jony6/-MechanicalDesign/README.org

#+TITLE: 机械设计项目说明
** 六自由度机械臂
 [[https://github.com/fhln/-MechanicalDesign/tree/master/%E5%85%AD%E8%87%AA%E7%94%B1%E5%BA%A6%E6%9C%BA%E6%A2%B0%E8%87%82][腕关节正交结构机械臂]]，可以通过得到运动学解析解。
** 软体手爪
 自主研发的[[https://github.com/fhln/-MechanicalDesign/tree/master/%E8%BD%AF%E4%BD%93%E6%89%8B%E7%88%AA][欠驱动柔性手爪]]，具有三种抓取模式，可以在非结构化环境中抓取各种尺寸、材质的物体，软体材料固有的柔性保证其抓取过程的安全性灵活性，表面采用微型吸盘阵列改善抓取力和抓取效果，同时附有真空气压、微型触碰开关等传感器，具有一定的自感知和自动抓取能力。
*** Publications&Award
    + [[http://2017.icrita.org/?p=1051][Design and Analysis of a Novel Sucked-type Underactuated Hand with Multiple Grasping Modes]]
    + A New Grasping Mode Based on a Sucked-Type Underactuated Hand [J]. Chinese Journal of Mechanical Engineering, Accepted
    + 2017 RoboCup@Home Best in Manipulation Award (Nagoya, Japan)
*** \cite:
  @inproceedings{lin2017design,
  title={Design and Analysis of a Novel Sucked-Type Underactuated Hand with Multiple Grasping Modes},
  author={Lin, Nan and Wu, Peichen and Tan, Xiao and Zhu, Jinhua and Guo, Zhenjiang and Qi, Xinbo and Chen, Xiaoping},
  booktitle={International Conference on Robot Intelligence Technology and Applications},
  pages={299--312},
  year={2017},
  organization={Springer}
}
** 软体机械臂
   [[https://github.com/fhln/-MechanicalDesign/tree/master/%E8%BD%AF%E4%BD%93%E6%9C%BA%E6%A2%B0%E8%87%82][硅胶变刚度软体机械臂，具有无限自由度]]
** 软体驱动器
   Coming soon..
