jony6/-MechanicalDesign/软体手爪/README.org

#+TITLE: 软体手爪
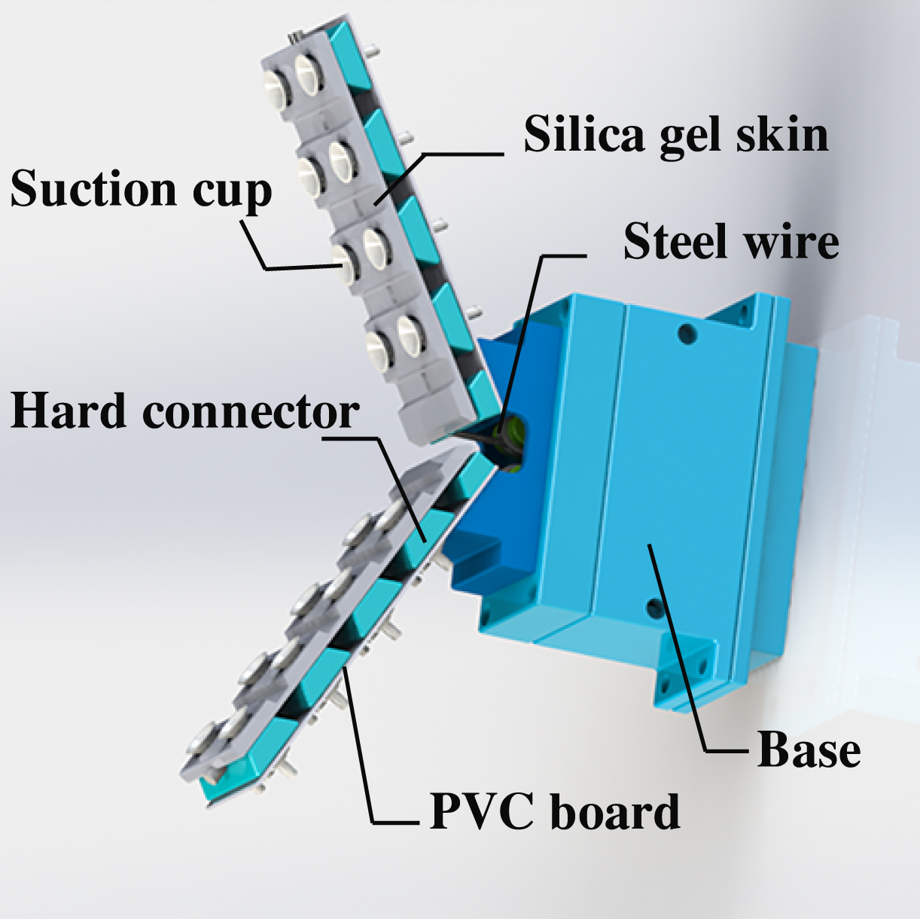
[picture p1: 软体手爪/img/schematic.jpg]

柔性被动自适应手爪，结构如上图所示.可以抓取多种物体. 用于可佳机器人获得RoboCup@Home 2017 [[https://www.ustc.edu.cn/news/mtgz/201708/t20170803_280644.html][Best in Manipulation Award]] (Japan) 和 RiTA conference 2017 [[http://2017.icrita.org/?p=1051][Best Paper Award]] .

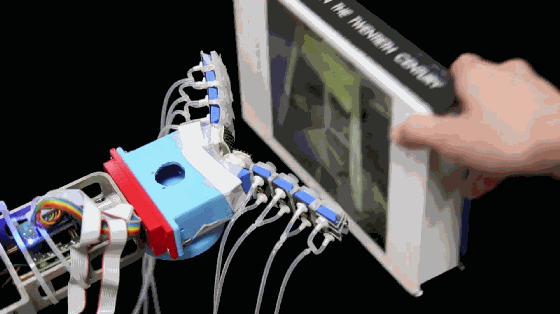
[picture p2: 软体手爪/img/书.gif]

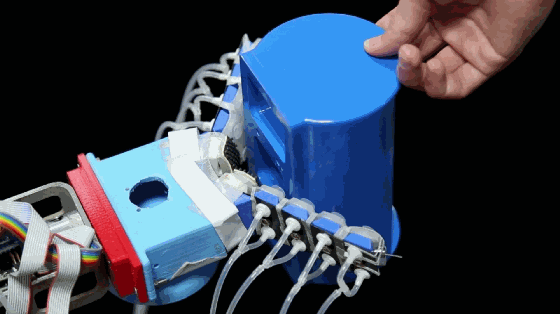
[picture p3: 软体手爪/img/可佳云台壳子.gif]

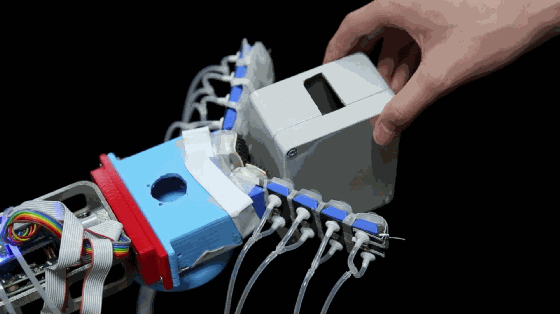
[picture p4: 软体手爪/img/塑料盒.gif]

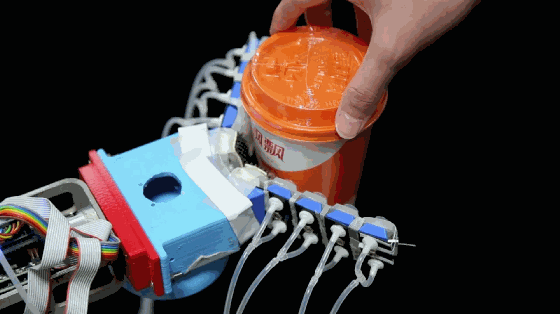
[picture p5: 软体手爪/img/奶茶.gif]

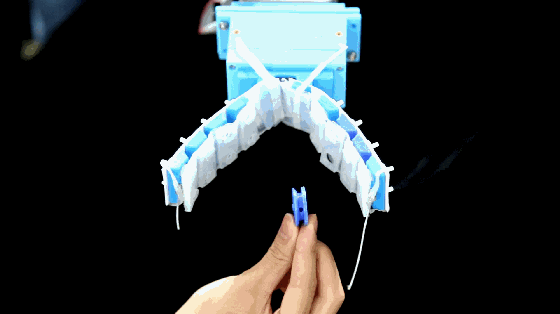
[picture p6: 软体手爪/img/小零件.gif]


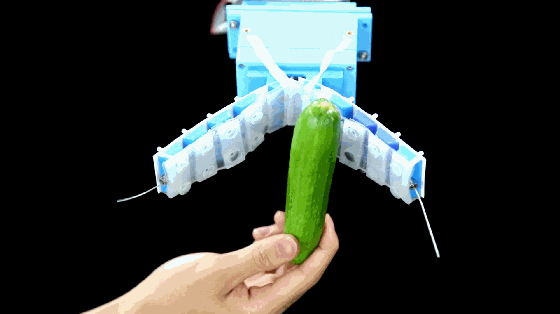
[picture p7: 软体手爪/img/捏黄瓜.gif]

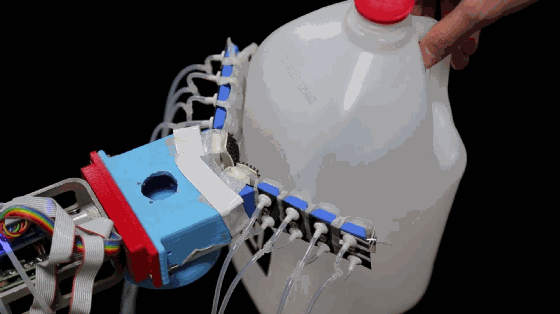
[picture p8: 软体手爪/img/水桶.gif]

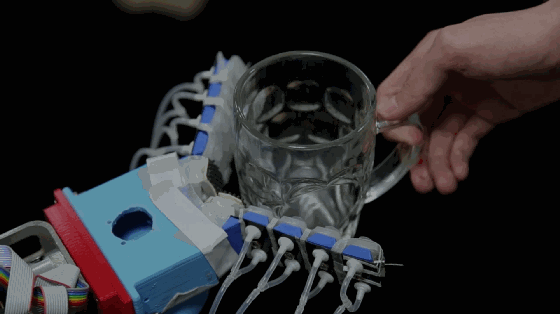
[picture p9: 软体手爪/img/玻璃杯.gif]

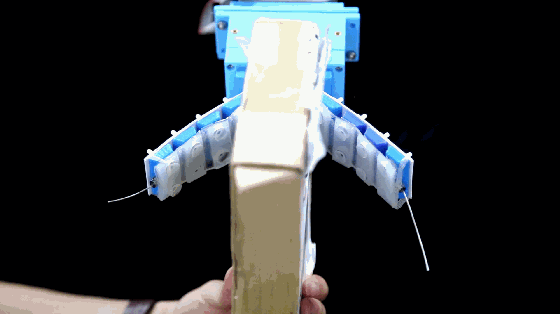
[picture p10: 软体手爪/img/盒子.gif]

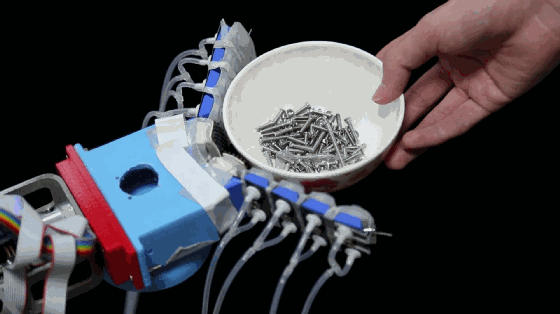
[picture p11: 软体手爪/img/盛物碗.gif]

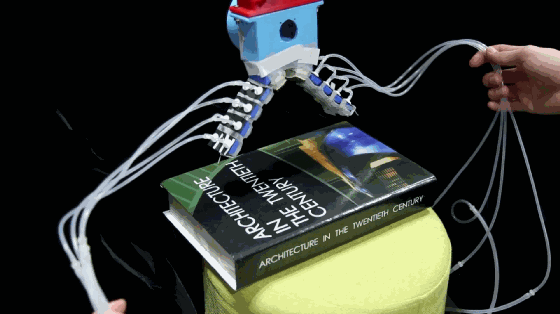
[picture p12: 软体手爪/img/竖直抓书.gif]

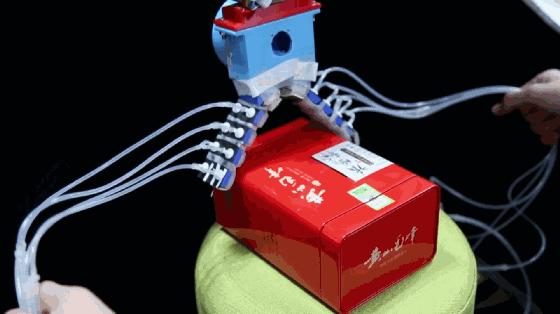
[picture p13: 软体手爪/img/竖直抓茶叶盒.gif]

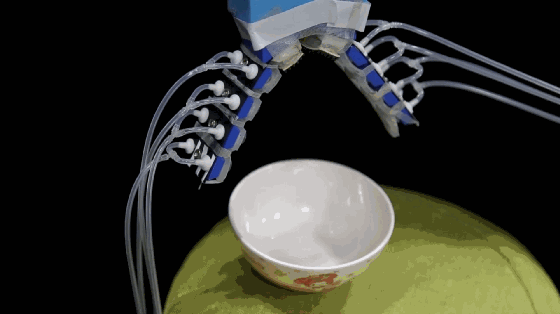
[picture p14: 软体手爪/img/纵向抓碗.gif]

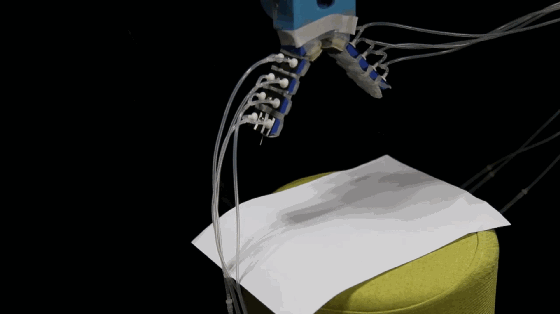
[picture p15: 软体手爪/img/纸.gif]

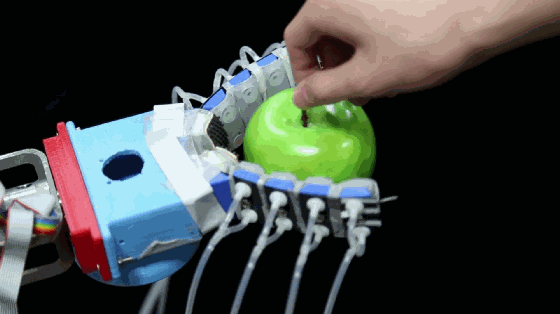
[picture p16: 软体手爪/img/绿苹果.gif]

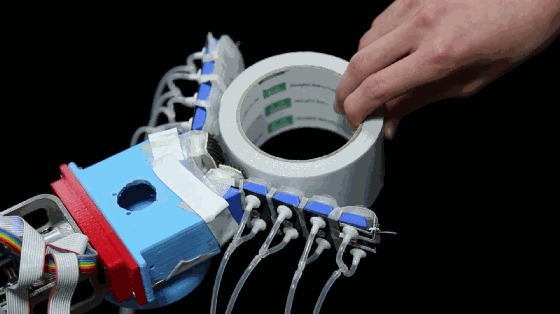
[picture p17: 软体手爪/img/胶带.gif]

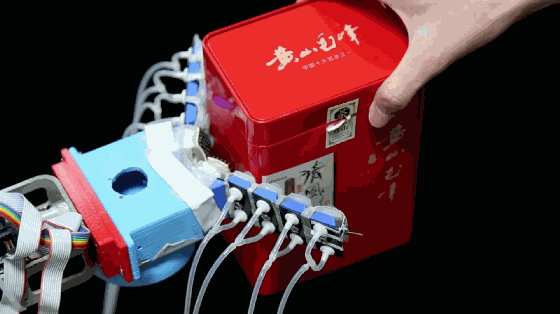
[picture p18: 软体手爪/img/茶叶罐.gif]

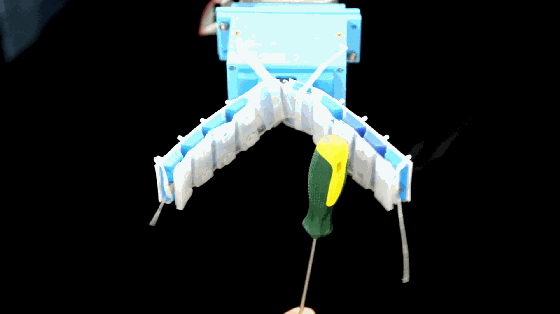
[picture p19: 软体手爪/img/螺丝刀.gif]

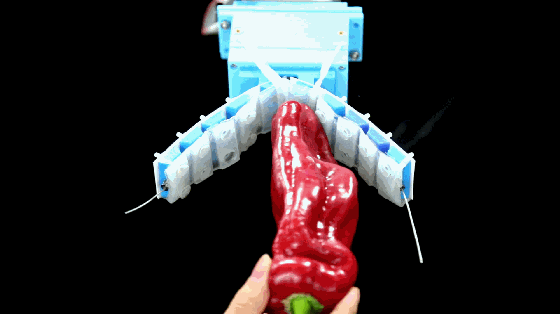
[picture p20: 软体手爪/img/辣椒.gif]

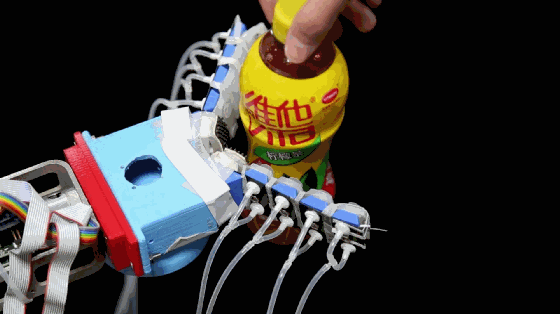
[picture p21: 软体手爪/img/饮料瓶.gif]

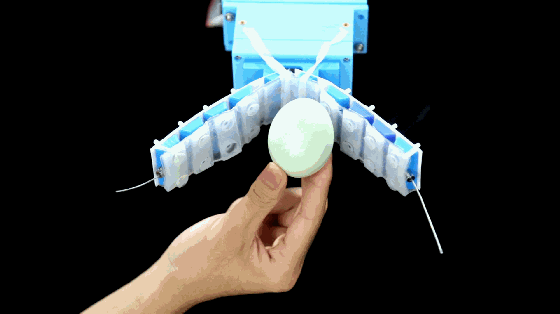
[picture p22: 软体手爪/img/鸭蛋.gif]
