jony6/-MechanicalDesign/六自由度机械臂/建模分析.pdf

中国科学技术大学学士学位论文

### 第三章 机械臂运动学和动力学

### 3.1 运动学简介

机械臂运动学最基本的目的是得到关节空间到末端操作件的位姿的映射关 系。此由变换矩阵 ⁰

nT 唯一确定。关节变量定义为 q=[q1, ...qn]

n。因此，运动学
问题即是研究 q 与 0

nT 之间的关系。
运动学问题可分为两类。一个是正运动学问题，已知关节变量 q 求相应的

0

nT(q)。另一个是逆运动学问题，即已知 ⁰

nT，求出对应的 q。另外还有一些问题，
如求工作空间、奇异点的位置，也可以算是运动学的衍生。

### 3.1.1 刚体位姿的表述

自由刚体在空间中有六个自由度，因此可以通过六个参数来确定刚体在空 间中的位姿。刚体的指向可以通过其与参考坐标系的相对位置来描述。记刚体坐 标系 O1ξηζ（以下简称系 1）中的三个单位向量 n、o、a 在参考坐标系 OXYZ(以 下简称系 0) 中的表达式是

0n =

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
则可以用 3X3 的矩阵来表示刚体相对参考坐标系的指向：

0R1 ≜

nx | ox | ax
ny | oy | ay
nz | oz | az

=

[

0n

0o

0a

]

### 3.1.2 旋转变换

如果标记旋转前的坐标系为系 0，旋转后的坐标系为系 1，称 0R1 为从系 0 到系 1 的旋转矩阵。如有一个矢量 b,b 在系 0 中的表示为 0b，在系 1 中的表示 为 1b，则

1b =
0 R1 ·

0 b

### 3.1.2.1 基本旋转矩阵

绕坐标轴 X、Y、Z 旋转称为基本旋转。对应的旋转矩阵为

Rx =

1 | 0 | 0
0 cos θ − sin θ
0 sin θ cos θ

, Ry =

cos θ | 0 sin θ
0 | 1 | 0
− sin θ 0 cos θ

, Rz =

cos θ − sin θ 0
sin θ | cos θ | 0
0 | 0 | 1

,

### 3.1.2.2 欧拉角

对于每个任意的指向，都可以通过 3 个连续绕坐标轴的转动来实现。这三个 转角称为欧拉角 {φ, θ, ψ}。ZYZ 欧拉角的旋转矩阵表示为:

0R1 = Rz(φ)Ry(θ)Rz(ψ) =

cφ −sφ 0
sφ | cφ | 0
0 | 0 | 1
cθ | 0 sθ
0 | 1 0
−sθ 0 cθ

cψ −sψ 0
sψ | cψ | 0
0 | 0 | 1

(3.1)

其中，cφ ≜ cos φ, sφ ≜ sin φ，其他类推。

### 3.1.2.3 齐次变换矩阵

不同坐标系中的平移和旋转变换，可以表示成：

0
r =

0 p1 +

0 R1 ·

1
r

这个不是一个齐次的表达式，为了简化多个坐标系时的表示，定义以下形式：
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
0 | 1 ] [1r
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
0 | 0 | 0 | 1 ] [1r
| | | 1

]

(3.2)

这样，多个坐标系的变换，可以统一表示为：

0
nT =

0/1 T ·
1/2 T · · ·

n−1
n T

### 3.2 D-H 方法

六自由度机械臂采用的是串联结构，可看做由若干刚性杆首尾相连而成。常 用的建立与各杆固连坐标系的方法式 Danevit，Hartenberg 提出的 D-H 法。

### 3.2.1 D-H 参数

如图3.1所示，由于我们设计的机械臂均采用旋转关节，机械臂中的关节决 定两相邻构建之间的连接关系, 成为运动副。杆的近端关节为 i, 远端关节是 i+1。 驱动力 i 的力（或者力矩）通过关节 i 的轴线施加到杆 i 上。定义下面的参数：

1. 杆件长度 ai: 从 Zi 到 Zi+1 的距离，沿 Xi 轴指向为正。
2. 杆件扭角 αi: 从 Zi 到 Zi+1 的转角，绕 Xi 轴正向转动为正。
3. 关节距离 di: 从 Xi−1 到 Xi 的距离，沿 Zi 轴指向为正。
4. 关节转角 θi: 从 Xi−1 到 Xi 的转角，绕 Zi 轴正向转动为正。

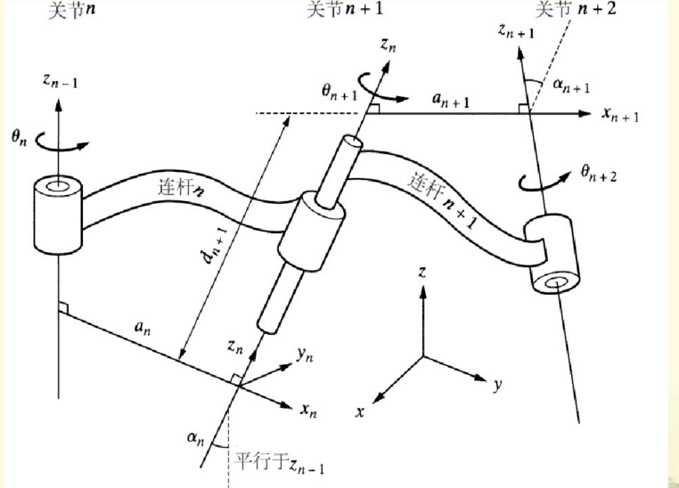
[picture p23: figure]

图 3.1 D-H 法

### 3.2.2 驱动轴坐标系的建立

第一步：确定 Zi 轴，基本原则是：Zi 轴沿关节 i 的轴向。 第二步：确定原点 Oi。Oi 在过 Zi 和 Zi+1 轴的公法线上。
第三步：确定 Xi，Xi 轴沿过 Zi 和 Zi+1 的公法线方向，从 Zi 指向 Zi+1。 第四步：确定 Yi 轴，Yi = Zi × Xi，使得坐标系为右手坐标系。 则从坐标系 {i} 到坐标系 {i+1} 的变换矩阵为：

i
i+1
T = T ransx(ai) · Rotx(αi) · T ransz(di) · Rotz(θi) | (3.3)

### 3.2.3 六自由度机械臂运动学模型

六自由度机械臂的机构运动简图如下图所示3.2, 第一关节和机架的为 L1, 第 二和第三关节的距离为 L2，第三关节距离腕关节为 L3，图中的距离 0 表示三个 关节正交于腕关节一点上。腕关节距离手爪为 L4。
在此运动结构上，建立 D-H 坐标系3.3。D-H 参数表如下图。
表 3.1 | D-H 参数表
i | αi−1 | ai−1 | di | θi | 初始角 | 范围
1 | 0 | 0 | -L1 | θ1 | 0 | [-90°,90°]
2 | -90° | 0 | 0 | θ2 | 90° | [0,90°]
3 | 0 | L2 | 0 | θ3 | -90° | [-180°,-90°)
4 | -90° | 0 | L3 | θ4 | 180° | (90°,270°]
5 | -90° | 0 | 0 | θ5 | 90° | [60°,120°]
6 | -90° | −L4 | 0 | θ6 | 0 | [-30°,30°]

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

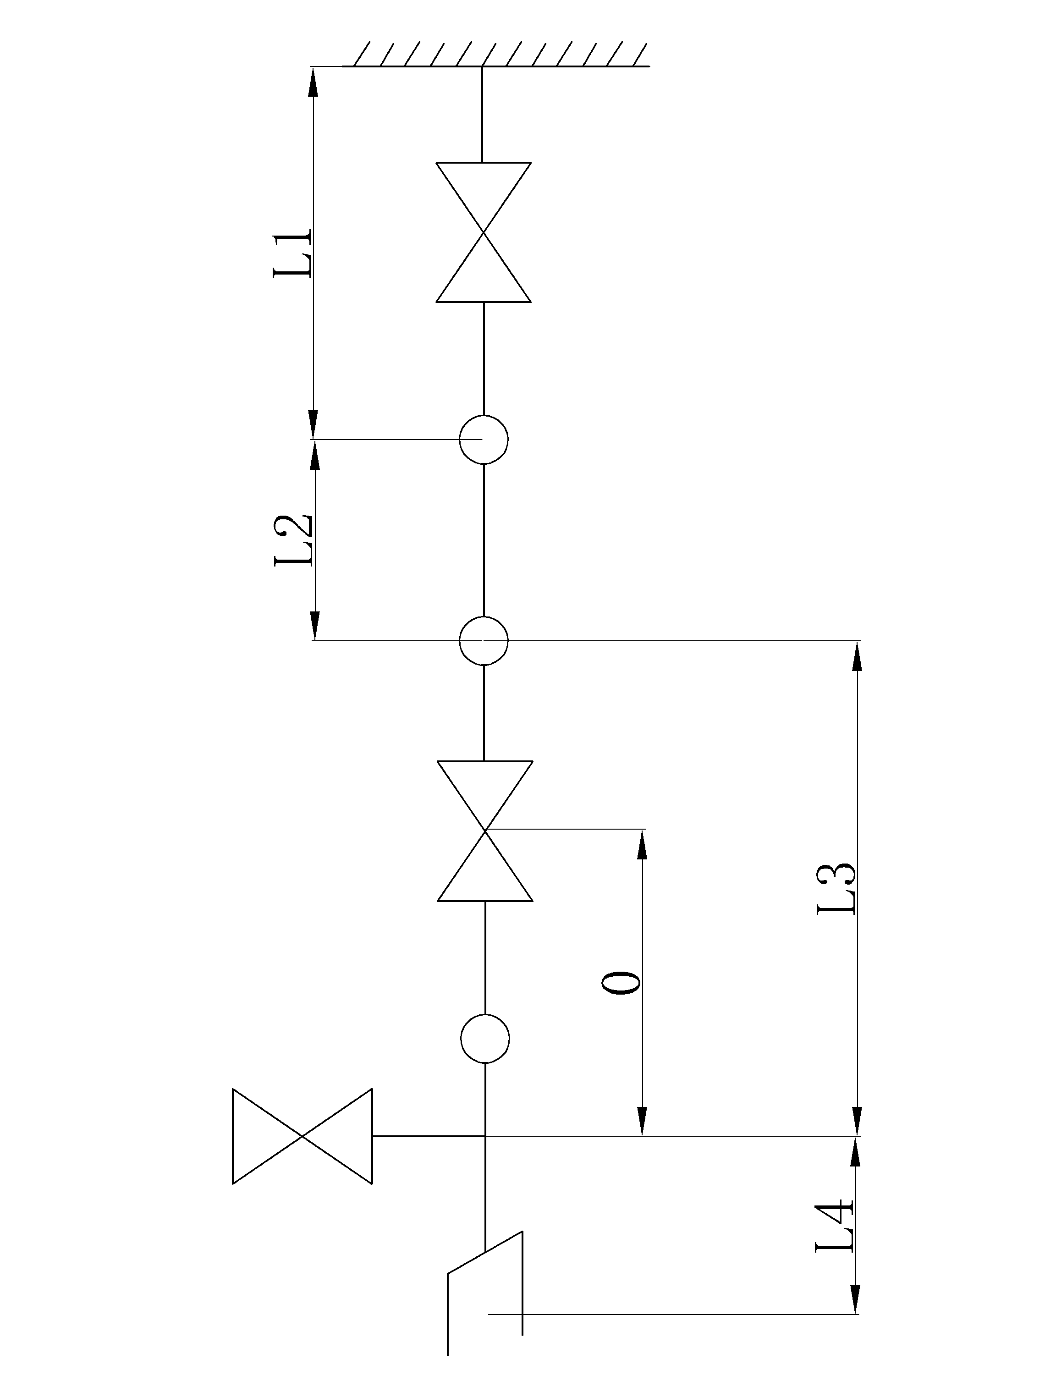
[picture p24: figure]

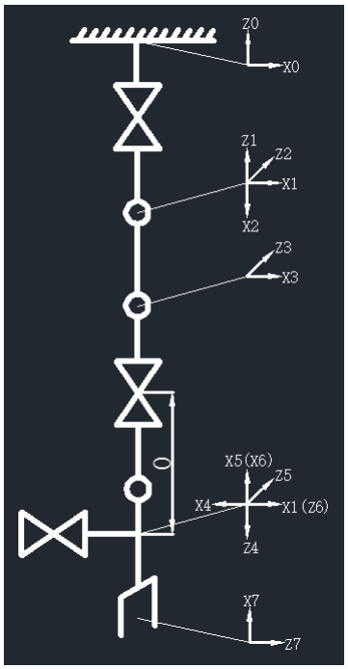
[picture p25: figure]

图 3.3 机械臂固连坐标系

### 3.2.5 机械臂逆运动学解

逆运动学即为已知 ⁰

nT，求对应的 q。其中，⁰

nT 通过传感器如 GDR-D 相机、
双目相机或者激光测距仪等测得。可佳上用 kinect 和高清工业相机结合实现对 物体的识别定位和抓取。

### 3.2.5.1 逆运动学解法

前文提及，六自由度机械臂后三个关节轴线交于一点，逆运动学问题必有解 析解。这里，通过对前后三个关节解耦来求解。[8] 设坐标系 4 原点为 O4，矢径 p4 ≜

−−−→ O0O4,X6 是坐标系 6 的 X 轴单位矢量。

定义：

p4 + (−L4)X6 = p6

在 0 坐标系下的表示为：

0p4 + (−L4)

0X6 =

0 p6 | (3.6)

已知

0
6T =

[
0R6

0P6

0 1 ]

=

[
0X6

0Y6

0Z6

0p6

0 | 0 | 0 | 1 ]

从齐次变换矩阵的定义可知，⁰p4 =⁰ p6 + L
0

4X6 是 ⁰
3T =⁰
1 T ·

1
2 T ·

2

3 T · T34 的最后
一列三个元素。其中：

T34 =

1 0 0 0
0 1 0 L3
0 0 1 0
0 0 0 1

0p3 ≜ [px, py, pz]

0
3T · T34 =
value11 | value12 | value13 | L2C1C2 − L3(C1C2C3 + C1S2C3)
value21 | value22 | value23 | L2S1C2 − L3(S1C2S3 + S1S2C3)
value31 | value32 | value33 | −L1 − L3(C2C3 − S2S3) − L2S2
0 | 0 | 0 | 1
| | | (3.7)
联立方程组3.7，得

L2C1C2 − L3(C1C2C3 + C1S2C3) = px

L2S1C2 − L3(S1C2S3 + S1S2C3) = py
−L1 − L3(C2C3 − S2S3) − L2S2 = pz
| | | (3.8)

因为计算机存在舍入误差，在求解机器人逆运动学时，需要避免求解一些计 算精度不高的函数。
一般不采用反三角函数 arccos 或者 arcsin。因为它们不能在 [−π, π] 范围内唯 一确定出角度，而且误差较大。∀y = f(x), 误差 △y ≈ f

′
(x)△x, 对于 y = arccos x，
△y ≈ −√

1
1−x²△x，当 x 在定义域 (-1,1) 中变化时，(arccos x)

′ 值在 (−∞, −1) 之
间变化。如果用反正切函数，y = atan(x), 则 △y ≈

1
1+x²△x，当 x 在 (−∞, ∞)
变化时，arctan x 仅在 (0, 1] 之间变化。因此，用反正切（反余切）函数比用反正 弦（反余弦）函数更精确。一般采用双变量反正切函数 atan2 x

y 在 [−π, π] 内唯
一确定角度。

### 3.2.5.2 求前三个关节变量

下面解方程3.8, 得到前三个关节变量 q1q2q3。

1. 求 θ3

0P4 =

0 P6 +

0 X6L4 = [px, py, pz]
T

0P1 = [0, 0, 0]
T − L1[0, 0, 1]

T = [0, 0, −L1]

T

可以得到三角形 O1O3O4 中的勾股关系。

L

2
2 + L

2

3 − 2 · cos(270◦ + θ3) = p
2
x + p

2
y + (pz + L1)

2
(3.9)

由方程3.9可以解出 θ3

2. 求 θ2

整理方程组3.8, 可以得到：

pz + L1 = (S3L3 − L2)S2 − (L3C3)C2 | (3.10)

得到：
θ2 = atan2[
S3L3−L2, −L3C3

]

±atan2(√
(S3L3 − L2)
2 + (L3C3) | 2 − (pz + L1)

2, pz+L1

)

| (3.11)
3. 求 θ3

py = S1

[
L2C2 − L3(C2S3 + S2C3)

]
px = C1

[
L2C2 − L3(C2C3 + S2C3)

]

θ1 = atan2(S1, C1) | (3.12)

### 3.2.5.3 求解后三个关节变量

3/6 T = (⁰
3

T)

−1
·

0/6 T ≜

[
3X6

3Y6

3Z6

3P36

0 | 0 | 0 | 1 ]
≜
xb1 | yc1 | zb1 | p1
xb2 | yc2 | zb2 | p2
xb3 | yc3 | zb3 | p3
0 | 0 | 0 | 1

3/6 T =

3/4 T·

4/5 T·
5/6 T =
S4S6 + C4C5C6 | C6S4 − C4C5S6 | −C4S5 | −L4C4C5
−C6S5 | S5S6 | −C5 | L4S5 − L3
C4S6 − C5C6S4 | C4C6 + C5S4S6 | S4S5 | L4C5S4
0 | 0 | 0 | 1

≜

[
3R6

3P36

0 1 ]

分以下情况讨论：

1. 若 zb1, zb3 不全为零，则 S5 ̸= 0
{
−C4S5 = zb1

S4S5 = zb3

(3.13)

得：

θ4 = atan2(

zb3S5
−zb1S5

) = π
2

− atan2(

zb1S5

zb3S5

) = { π
2 − atan(

zc1
zc3

) if S5 > 0

−

π
2 − atan(
zc1 zc3 | ) if S5 < 0
{
−C6S5 = xb2

S6S5 = yc2

| (3.14)

得：

θ6 = atan2(

yc2S5
−xb2S5

) = π
2

−atan2(

xb2S5

yc2S5

) = { π
2 − atan2(

xc2
yc2

) if S5 > 0

−

π
2 − atan2(
xc2 yc2 | ) if S5 < 0
{
−C4S5 = zb1

S4S5 = zb3

⇒

{
−C

2
4
- S5 = zb1C4
S

2
4
- S5 = zb3S4

⇒

{
S5 = zb3S4 − zb1C4
C5 = −zb2

θ5 = atan2(

zb3S4 − zb1C4
−zb2

)

2. 若 zb1, zb3 全为零

C5 = −zb2 ⇒ θ5 = (1 + zb2)

π
2
为 0 或者 π，此时其实已经不再范围内。

3
6R =
S4S6 − C4C6zb2 | S4C6 + C4S6zb2 | 0
0 | 0 | zb2
C4S6 + C6S4zb2 | C4C6 − S4S6zb2 | 0

=

−zb2 cos(θ4 + θ6zb2) zb2 sin(θ4 + zb2θ6) 0
0 | 0 | zb2
sin(θ4 + zb2θ6) | cos(θ4 + θ6zb2) | 0

⇒ zb2 tan(θ4 + zb2θ6) = yc1 yc3

⇒ θ4 + zb2θ6 = atan2(

yc1
yc3 · zb2

)

有无穷多组解

### 3.3 机械臂动力学

机械装置的运动需要建立动力学方程。即，只要知道所受的力和力矩就能确 定机械装置的运动状态。通常可用 newton 力学等方法来确定机器人动力学方程。 然而由于机械臂是一个耦合的、多自由度的复杂机械机构，求其动力学方程很困 难。本文采用拉格朗日力学建立机械臂的动力学方程。

### 3.3.1 Lagrange 力学方程

Lagrange 力学的基础是系统能量对系统变量及时间的微分。以两个基本方 程为基础：一个针对直线运动，另一个针对旋转运动。定义 Lagrange 函数为：

L = K − P | (3.15)

其中 L 是 Lagrange 函数，K 是系统动能，P 是系统势能。经过推导 [7]，给出力 和力矩的表示式：

Fi =

∂
∂t(

∂L ∂x˙ i

) − ∂L ∂xi | (3.16)

Fi =

∂
∂t(

∂L ∂θ˙ i

) − ∂L ∂θi | (3.17)

其中 Fi 是产生直线运动的所有外力的和，Ti 是产生所有转动的所有外力的和。 θi 和 xi 是系统变量。

### 3.3.1.1 刚体动能

由理论力学的知识可知，刚体三维运动的动能为：

K =

1
2

mv²
G +

1
2
ω · hG | (3.18)

其中 hG 是刚体关于 G 点的角动量。
刚体做平面运动时，动能则可以简化为：

K =

1
2

mv²
G +

1
2
Iω² | (3.19)

6 自由度机械臂，坐标系变换为：

0/6 T =
0/1 T

1/2 T · · ·

5/6 T ≜ A1A2 · · · A6 | (3.20)

对于旋转关节的齐次变换矩阵，

∂Ai
∂θi

=

∂
∂θi
Ci | −SiCαi | SiSαi | aiCi
Si | Cαi
- Ci | −Sα−1Ci | aiSi
0 | Sαi | Cαi | di
0 | 0 | 0 | 1

=

−Si | −CiCαi | CiCαi | aiSi
Ci | Cαi
- Si | Sαi
- Si | aiCi
0 | 0 | 0 | 0
0 | 0 | 0 | 0

(3.21)
该矩阵可以分解为一个常数矩阵 Qi 和矩阵 Ai 的乘积：
−Si | −CiCαi | CiCαi | aiSi
Ci | Cαi
- Si | Sαi
- Si | aiCi
0 | 0 | 0 | 0
0 | 0 | 0 | 0

=

0 −1 0 0
1 | 0 | 0 0
0 | 0 | 0 0
0 | 0 | 0 0

·

Ci | −SiCαi | SiSαi | aiCi
Si | Cαi
- Ci | −Sα−1Ci | aiSi
0 | Sαi | Cαi | di
0 | 0 | 0 | 1

(3.22)

可表示为:
∂Ai
∂θi
= QiAi | (3.23)

以此类推，定义：

Uij =

∂

0
i

T
∂qj

=

∂(A1A2 · · · Aj

- · · Ai)
∂qj

= A1A2 · · · QjAj

- · · Ai | (3.24)

Uijk =

∂Uij
∂qk

(3.25)

设 ri 表示相对于机械臂第 i 连杆坐标系的点。则该点的速度：

vi =

d
dt

(
0
i

T · ri

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
dt )

- ri | (3.26)

T race (
vi · v

T
i

)
= T race

x˙i

2 | x˙iy˙i | x˙iz˙i
y˙ix˙i | y˙i
| 2 | y˙iz˙i
z˙ix˙i | z˙iy˙i | z˙i
| | 2

(3.27)

可以得到质量元的动能方程为：

dKi =

1
2

T race [(∑
i

p=1

(

Uip

dqp
dt
- ri

)) (

Uip

dqp
dt
- ri

)T

]

(3.28)

最终得到总的动能：

Ki =

∫
dKi =

1
2

T race [∑
i

p+1

∑
i

r=1

Uip (∫
rir

T
i dmi

)
U

T
irq˙ pq˙ r

]

(3.29)

经过推导，有：
∫
rir

T
i dmi =

∫
x

2
idmi

∫
xiyidmi

∫
xizidmi

∫
xidmi
∫
xiyidmi

∫
y

2
idmi

∫
yizidmi

∫
yidmi
∫
xizidmi

∫
yizidmi

∫
z

2
idmi

∫
zidmi
∫
xidmi

∫
yidmi

∫
zidmi

∫
dmi

(3.30)

定义3.30为以下形式：

Ji =

1
2
(−Ixx + Iyy + Izz)i | Iixy | Iixz | mix¯ i

Iixy

1
2
| (Ixx + Iyy − Izz)i | Iiyz | miy¯ i
Iixz | Iiyz

1
2
| | (Ixx + Iyy − Izz)i | miz¯i
mix¯ i | miy¯ i | miz¯i | mi
| | | (3.31)
于是动能方程3.29的最终形式:

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
T race (
UipJiU

T

ir)
q˙ pq˙ r +

1
2

∑n

i=1

Ii(act)q˙

2
i

(3.32)

其中，Ii(act) 是电机和谐波减速器的转动惯量。

### 3.3.1.2 势能

P =

∑n

i=1

Pi =

∑n

i=1

[
−mig

T
- (

0
i

T · r¯i)

]
(3.33)

### 3.3.1.3 机器人运动方程

由参考文献 [9] 得到机械臂最终运动方程为：

Ti =

∑n

j=1

Dijq¨j + Ii(act) +

∑n

j=1

∑n

k=1

Dijkq˙jq˙k + Di | (3.34)

其中，

Dij =

∑n

p=max(i,j)

T race (
UpjJpUT
pi) | (3.35)

Dijk =

∑n

p=max(i,j,k)

T race (
UpjkJpUT
pi) | (3.36)

Di =

∑n
p=i −mpg
TUpir¯p | (3.37)

### 3.3.2 一般六自由度机械臂动力学解

对于一个六自由度转动关节机械臂，3.34方程可展开为：

Ti = Di1θ¨

1 + Di2θ¨

2 + Di3θ¨

3 + Di4θ¨

4 + Di5θ¨

5 + Di6θ¨

6 + Ii(act)θ¨
i
+ Di11θ˙
1

2
+ Di22θ˙
2

2
+ Di33θ˙
3

2
+ Di44θ˙
4

2
+ Di55θ˙
55

2
+ Di66θ˙
66

2

+ Di12θ˙

1θ˙

2 + Di13θ˙

1θ˙

3 + Di14θ˙

1θ˙

4 + Di15θ˙

1θ˙

5 + Di16θ˙

1θ˙
6
+ Di21θ˙

2θ˙

1 + Di23θ˙

2θ˙

3 + Di24θ˙

2θ˙

4 + Di25θ˙

2θ˙

5 + Di26θ˙

2θ˙
6
+ Di31θ˙

3θ˙

1 + Di32θ˙

3θ˙

2 + Di34θ˙

3θ˙

4 + Di35θ˙

3θ˙

5 + Di36θ˙

3θ˙
6
+ Di41θ˙

4θ˙

1 + Di42θ˙

4θ˙

2 + Di43θ˙

4θ˙

3 + Di45θ˙

4θ˙

5 + Di46θ˙

4θ˙
6
+ Di51θ˙

5θ˙

1 + Di52θ˙

5θ˙

2 + Di53θ˙

5θ˙

3 + Di54θ˙

5θ˙

4 + Di56θ˙

5θ˙
6
+ Di61θ˙

6θ˙

1 + Di62θ˙

6θ˙

2 + Di63θ˙

6θ˙

3 + Di64θ˙ 6θ˙ 4 + Di65θ˙ 6θ˙ 5 + Di | (3.38)

### 3.3.3 六自由度机械臂简化动力学解

以上的动力学解包括了重力项、离心力项、科氏力、耦合力等，计算较为复 杂，一般会忽略次要作用力 [10]。考虑到设计的腕部正交结构，机构可以简化成 如图3.4：
其中，腕部是球铰结构。Jmi, i = 1 · · · 6 是第 i 个电机和谐波减速器折合 在输出轴上的转动惯量，。mrk, k = 1 · · · 6 是第 i 个电机和谐波减速器的质量。 Imi, i = 1 · · · 6 是第 i 个连杆的转动惯量,mik, k = 1 · · · 6 是第 i 个连杆的质量。di 是杆端到连杆质心的长度。

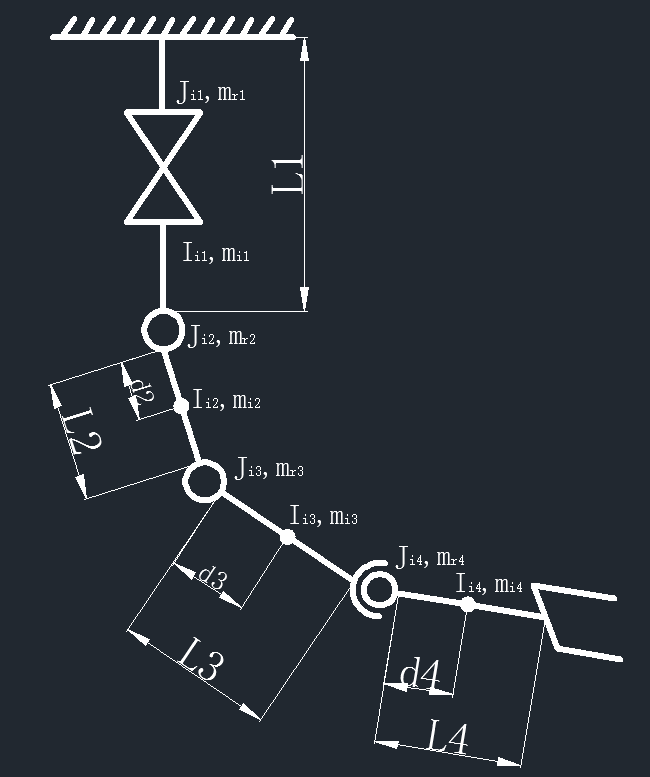
[picture p26: figure]

图 3.4 六自由度机械臂动力学简图

电机和减速器一（下面简称成驱动装置）等效转子的动能为：

| Km1 =
| 1
| 2 Jm1θ˙
| 1
| 2
(3.39)

连杆一的动能为：

| Kl1 =
| 1
| 2 Il1θ˙
| 1
| 2
(3.40)

驱动装置二的动能为 (假设忽略转子在非转轴方向上的惯量):

| Km2 =
| 1
| 2 Jm2θ˙
| 2
| 2
(3.41)

连杆二的动能为：

Kl2 =

1
2
ml2 [ | (d2θ˙ 2) 2 + (θ˙ 1d2 sin θ2)
| 2

]
| +

1
2

Il2θ˙²
2

(3.42)

驱动装置三的动能为：

Km3 =

1
2

mr3 [
(q˙ 2L2)

2 + (θ˙
| 1L2 sin θ2)
| 2

]
| +
| 1
| 2 Jm3 (
θ3 + θ˙
2

)2
(3.43)

连杆三的动能：

Kl3 =

1
2

ml3 [((θ˙

2 + θ3

)
d3 + θ˙
2L2C3

)2
+

(
θ˙
2L2S3

)2
+

(
(L2S2 + d3S23) θ˙
1

)2

]

+

1
2

Il3 (
θ˙

2 + θ˙
3

)2

(3.44)
驱动装置四的动能为：

Km4 =

1
2

mr4[[(
L2S2 + L3S23)
θ˙
1

]2
+

(
θ˙
2L2C3 +

(
θ˙

2 + θ˙
3

)
L3

)2
+

(
θ˙
2L2S3

)2

]

+

1
2

Jm4(
θ˙

2 + θ˙

3 + θ˙
4

)2

(3.45)
连杆四的动能：

K14 =

1
2

ml4[(
L2S2 + L3S23 + d4S234)2
θ˙²
1 + L

2

2θ˙²
2 + L

3/3(
θ˙

2 + θ˙
3

)2

+ d

2/4(
θ˙

2 + θ˙

3 + θ˙
4

)2
+ 2L2L3C3θ˙
2

(
θ˙

2 + θ˙
3

)
+ 2L2d4C34θ˙
2

(
θ˙

2 + θ˙

3 + θ˙
4

)

+ 2L3d4C4

(
θ˙

2 + θ˙
3

)(θ˙
2 + θ˙

3 + θ˙
4

)

]
+

1
2

Il4(
θ˙

2 + θ˙

3 + θ˙
4

)2

(3.46)
机械臂的总动能为：

K

(
θ, θ˙

)
= Km1 + Kl1 + Km2 + Kl2 + Km3 + Kl3 + Km4 + Kl4 | (3.47)

忽略机械臂的弹性势能，机械臂的总势能是：

P = − g

[
ml2d2C2 + mr3L2C2 + ml3(

L2C2 + d2C23)

+ mr4(

L2C2 + L3C23)

+ ml4(

L2C2 + L3C23 + d4C234)

]

| (3.48)
机械臂的运动模型是：
d
dt

∂L
∂θ

−

∂L
∂θ
= T | (3.49)

其中，T 是主动力系对应的广义力，这里对应每个关节等效输出轴扭矩。而 Lagrange 函数,

L = K − P

### 3.4 轨迹规划

由运动学可以得到机械臂末端的起始和终止位置，或者已知机械臂的期望 位姿确定相应的关节变量。轨迹规划则主要涉及到从开始位置到终点的轨迹序 列。其间要考虑机械臂的完成时间、运动平稳性和避障等要求。

### 3.4.1 关节空间和直角坐标空间

查阅资料 [11] 可知：描述机器人运动轨迹有关节空间描述和直角空间描述 两种方法。采用关节变量描述机器人的运动称为关节空间描述。这种方法使关节 变量连续，最终将机器人移动到期望的位置，但是机器人在首尾两点的运动是不 可预知的。直角坐标空间描述首先将运动序列在现实中三维直角坐标系中进行

描述，然后通过逆运动学方法转化成关节空间描述，驱动关节运动。这种方法得 到的是一条可控的运动轨迹，但是其计算量远远大于关节空间，实时控制的话对 硬件的计算要求很高，并且有奇异点问题。

### 3.4.2 关节空间轨迹规划

可佳机器人的实时性要求较高，因此采用关节空间的轨迹规划。 轨迹规划问题一般将轨迹规划器看成黑箱，接受路径约束条件为输入变量， 输出起点和终点之间按照时间排列的中间形态序列，这里用关节空间表述。如下 图所示：3.5

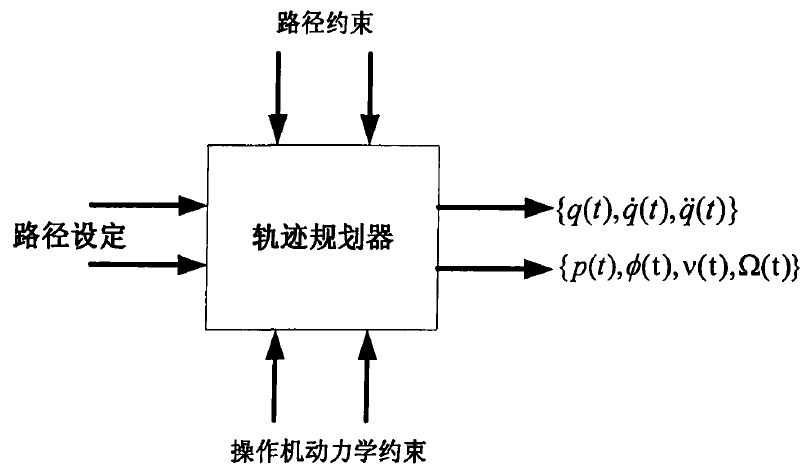
[picture p27: figure]

图 3.5 轨迹规划方框图

生成关节轨迹点的算法比较简单，流程图如图：3.6

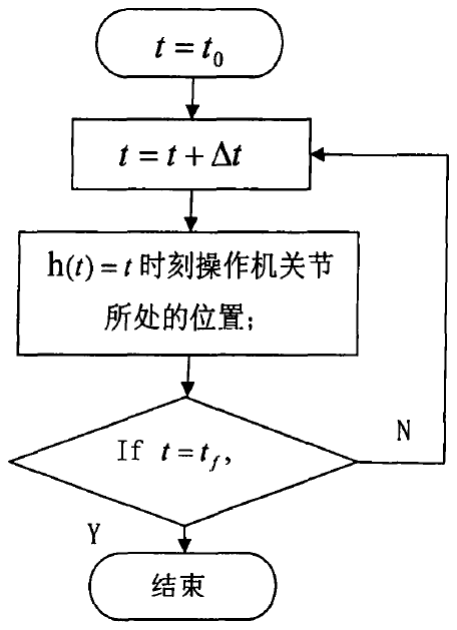
[picture p28: figure]

图 3.6 轨迹规划算法流程图

参考文献 [12] 对关节空间轨迹规划提出以下要求：

1. 方便迭代方法计算轨迹设定点。
2. 必须求出明确给定的中间位置。
3. 保证关节变量和前二阶时间导数的连续性，使得轨迹平滑。
4. 减少额外的运动。

### 3.4.3 多项式轨迹解法

可以采用多项式序列作为关节空间的时间函数，能满足上述要求。但如果对 路径上每一点都求解高次多项式，需要大量的计算。一种代替的方法是采用分段 的低次多项式，通过边界条件平滑连接。例如使用 4-3-4 轨迹、3-5-3 轨迹或者五 段三次多项式轨迹等来代替高次多项式。这里用 4-3-4 轨迹。

θ(t)1 = a0 + a1 · t + a2 · t

2 + a3 · t
3 + a4 · t

4

θ(t)2 = b0 + b1 · t + b2 · t

2 + b3 · t
3

θ(t)3 = a0 + a1 · t + a2 · t

2 + a3 · t
3 + a4 · t

4
(3.50)

将整个运动的标准化全局时间变量表示为 t，将第 j 个运动段的本地时间变 量表示成 τj

, 假设每一运动段的初始时间 τji 为 0，且给定每一运动段的终点本 地时间为 τjf。
设 θ1 为第一段四次多项式初值位置, θ2 为第一中间点位置，θ3 为第二中间 点位置，θ4 为最后一段四次多项式终值位置。由各个约束条件列出方程组：

θ1 = a0 | (3.51)
θ˙
1 = a1 | (3.52)
θ¨
1 = 2a2 | (3.53)

θ2 = a0 + a1τ1f + a2(τ1f)

2 + a3(τ1f)
3 + a4(τ1f)

4
| (3.54)
θ2 = b0 | (3.55)

a1 + 2a2(τ1f) + 3a3(τ1f)

2 + 4a4(τ1f)
3 = b1 | (3.56)

2a2 + 6a3(τ1f) + 12a4(τ1f)

2 = 2b2 | (3.57)

θ3 = b0 + b1(τ2f) + b2(τ2f)

2 + b3(τ2f)
3 | (3.58)
θ3 = c0 | (3.59)

b1 + 2b2(τ2f) + 3b3(τ2f)

2 = c1 | (3.60)
2b2 + 6b3(τ2f) = 2c2 | (3.61)

θ4 = c0 + c1(τ3f) + c2(τ3f)

2 + c3(τ3f)
3 + c4(τ3f)

4
| (3.62)
θ˙
4 = c1 + 2c2(τ3f) + 3c3(τ3f)

2 + 4c4(τ3f)
3 | (3.63)

θ¨
4 = 2c2 + 6c3(τ3f) + 12c4(τ3f)
2 | (3.64)

可以写成矩阵形式：

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
1 0 | 0 | 0 | 0 | 0 0 | 0 | 0 | 0 0 | 0 | 0 | 0
0 1 | 0 | 0 | 0 | 0 0 | 0 | 0 | 0 0 | 0 | 0 | 0
0 0 | 2 | 0 | 0 | 0 0 | 0 | 0 | 0 0 | 0 | 0 | 0
1 τ1f | τ
| 2
| if | τ
| | 3
| | 1f | τ
| | | 4
| | | 1f | 0 0 | 0 | 0 | 0 0 | 0 | 0 | 0
0 0 | 0 | 0 | 0 | 1 0 | 0 | 0 | 0 0 | 0 | 0 | 0
0 1 2τ1f 3τ²
1f 4τ³
1f 0 −1 | 0 | 0 | 0 0 | 0 | 0 | 0
0 0 | 2 | 6τ1f 12τ²
| | | | 1f 0 0 | −2 | 0 | 0 0 | 0 | 0 | 0
0 0 | 0 | 0 | 0 | 1 τ2f τ
| | | | | 2
| | | | | 2f | τ
| | | | | | 3
2f 0 0 | 0 | 0 | 0
0 0 | 0 | 0 | 0 | 0 0 | 0 | 0 | 1 0 | 0 | 0 | 0
0 0 | 0 | 0 | 0 | 0 1 2τ2f 3τ²
2f 0 −1 | 0 | 0 | 0
0 0 | 0 | 0 | 0 | 0 0 | 2 | 6τ2f 0 0 | −2 | 0 | 0
0 0 | 0 | 0 | 0 | 0 0 | 0 | 0 | 1 τ3f τ
| | | | | | | | 2
| | | | | | | | 3f | τ
| | | | | | | | | 3
| | | | | | | | | 3f | τ
| | | | | | | | | | 4
| | | | | | | | | | 3f
0 0 | 0 | 0 | 0 | 0 0 | 0 | 0 | 0 1 2τ3f 3τ²
3f 4τ³
| | | | | | | | | | 3f
0 0 | 0 | 0 | 0 | 0 0 | 0 | 0 | 0 0 | 2 | 6τ3f 12τ²
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
或者表示成：
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
(3.65)
从方程组3.66解得各个参数。
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
(3.66)

### 3.5 本章小结

本章在六自由度机械臂的结构基础上，分析了其运动学和动力学。通过运动 学可以控制机械臂运动到指定的控制位置，动力学则涉及到电机和驱动器实时 提供的力矩，来确定机械臂的受力状态。在确定机械臂起始、终止状态后，通过 轨迹规划和插补来控制机械臂运动过程的平滑性。这样，机械臂就能实现预期的 运动形式。本章也为后续的误差分析建立了基础。

### 第四章 机械臂误差分析

### 4.1 简介

在机械臂制造、装配过程中，不可避免存在误差。一些零部件在工作时也会 有偏差，从而对机械臂产生不利影响。运动学误差模型一般是通过分析机械臂 各个连杆之间的位姿误差与其运动学参数误差之间的关系，通过坐标系变化来 得到。对由于杆长公差和运动副内的间隙引起的机构运动误差常用有两种处理 方法：一是在每一个杆件上引进两个坐标系来考虑运动副间隙，二是将间隙折 算为机构结构误差的简化法 [13]。此外，可以通过矩阵法来确定连杆结构的运动 误差。

### 4.2 传动零部件误差

### 4.2.1 编码器测量误差

机械臂采用的是增量式光电编码器结合霍尔元件传感器。光电传感器利用 光电效应将电机的旋转转化成数字脉冲。通常采用莫尔条纹细分的方法来提高 编码器的分辨率。[14]
如果两路理想正弦莫尔条纹信号为：ua0 = A sin θ0, ub0 = A cos θ0,θ0 是理 论转角。

θ0 = arctan(

ua0

ub0

) = arctan(

A sin θ0
A cos θ0

)

实际中，收到环境影响，可以表示成：

ua = ua0 +

∑∞

k=1

Uak sin (θ + θa)ub = ub0 +

∑∞

k=1

Ubk cos(θ + θb)

其中 Uak 和 Ubk 为各次谐波振幅，θa 和 θb 为各次谐波相位。 实际的转角：

θR = arctan (

ua
ub

)

产生的误差：

△θ = θR − θ0 | (4.1)

### 4.2.2 谐波减速器误差

谐波减速器虽然是很精密的零部件，但是仍然存在钢轮和柔轮之间的啮合 误差。其误差公式为：

△φ =

+
− k · 3 · √
σ0 N/2 | (4.2)

其中，σ0Nk 分别是传动误差的均方根值、啮合区内工作齿数、影响系数。

### 4.2.3 同步带传动误差

同步带在张紧时多边形效应对传动有较大影响。设同步带轮的转角为 θ，则 同步带直线移动的位移理论上是:

Si = Rcθ

同步带轮实际上并不是做圆周运动，而是做弦运动。查阅文献 [15] 可知，多边形 效应引起的直线移动误差是：

△X = 2

[
Rcφ − Rr sin φ − (Rp + c)φ

]
(4.3)

其中 c 是同步带节线和同步带槽宽之间的距离，Rp 是顶圆半径，Rr 是齿顶 圆角圆心圆的半径。

### 4.2.4 锥齿轮空回误差

由于加工精度原因，锥齿轮空回误差对机械臂的传动影响较为严重。产生空 回误差的因素有以下几种 [16]：

1. 齿轮本身的误差

中心距增大导致：

jt1 = 2△a tan α

其中 a 是齿轮的中心距。

原始齿廓位移：

jt2 = Esi1 + Esi2

Esi 是齿厚极限偏差。

基圆偏心、齿形误差：

jt3 = (△F

′′
i1 + △F

′′
i2)tan α
△F

′′
i 是径向综合误差。
2. 齿轮与轴的配合间隙

jt4 = 2(e1 + e2)tan α

3. 轴承的误差

jt5 =

[
(E

′
D1 + E

′
D2) + (E

′′
D1 + E

′′
D2)

]
tan α

jt6 = (△1 + △2)tan α

E

′
D1E

′
D2 是固定座圈的径向跳动，E

′′
D1

E

′′
D2 是转动座圈的径向跳动。

齿轮总的侧隙公式为：

jt

∑ =

√
j

2
t1 + j

2
t2 + j

2
t3 + j

2
t4 + j

2
t5 + j

2
t6 | (4.4)

### 4.3 运动学误差模型

### 4.3.1 改进的 D-H 参数法

本文设计的六自由度机械臂关节 2 和 3 轴线相互平行，对于这种情况，Hayati 提出增加一个绕动系 ∑
iy 轴转动的角度 β 来解决 [17]。需要用到改进的 D-H 法。
定义 D-H 矩阵：

Ai = Rotzi,θi

T ranzidi

T ranxiaiRotziαiRotyiβi

=

CθiCβi − SθiSαiSβi | −CαiSθi | CθiSβi + SθiSαiCβi | aiCθi
SθiCβi + CθiSαiSβi | CαiCθi | SθiSβi − CθiSαiCβi | aiSθi
−CαiSβi | Sαi | CαiCβi | di
0 | 0 | 0 | 1

### 4.3.2 相邻连杆之间的位姿误差

设理想齐次变换矩阵为 AN

i ，实际齐次变换矩阵为 AR
i

, 由误差分析理论可知，

A

R
i = A

N
i + dAi | (4.5)

dAi =

∂AN
i
∂θi

△θi +

∂AN
i
∂di

△di +

∂AN
i
∂ai

△ai +

∂AN
i
∂αi

△αi +

∂AN
i
∂βi

△βi (4.6)

由文献 [17] 可知，偏导数可以表示成以下形式：

∂AN
i
∂θi

= DθiAN
i
∂AN
i
∂di

= DdiAN
i
∂AN
i
∂ai

= DaiAN
i
∂AN
i
∂αi

= DαiAN
i
∂AN
i
∂βi

= DβiAN
i

(4.7)

易得 Dki 是常数矩阵。如：

Dθi =

0 −1 0 0
1 | 0 | 0 0
0 | 0 | 0 0
0 | 0 | 0 0

因此，方程4.7等价于：

dAi =(Dθidθi + Ddiddi + Daidai + Dαidαi + Dβidβi )A

N
i
= δAiA

N
i

误差矩阵则是：

δAi =

0 | −△θi − Sαi△βi | Sθi△αi + CθiCαi△βi | dxi
△θi + Sαi△βi | 0 | −Cθi△αi + sθiCαi△βi | dyi
−Sθi△αi − CθiCαi△βi | Cθi△αi − SθiCαi△βi | 0 | dzi
0 | 0 | 0 | 0
| | (4.8)
其中，dxi

, dyidzi 是

∑

i 相对坐标系 ∑
i−1 的 xyz 方向的位置误差。

dxi = Cθi△ai − diSθi△αi − (diCθiCαi − aiSθiSαi
| | )△βi

dyi = Sθi△ai + diCθi△αi − (diSθiCαi + aiCθiSαi

| | )△βi

dzi = △di + aiCαi△βi

### 4.4 六自由度机械臂的误差

### 4.4.1 主导误差影响因素

在实际操作过程中发现，腕关节的加工装配难度很大，其他零件通过线切割 和精铣，精度较高。所以腕关节占了机械臂误差的主要部分。其主导误差包括：

1. 关节 4 和关节 5 的 x、y 偏置误差。
2. 关节 5 和关节 6 的 x 偏置误差。
3. 关节 6 由于锥齿轮间隙造成的空回误差。

齐次变换矩阵为：

0/6 T =

0/1 T · · ·
| 3/4 T[ 4/6 T + d 4/6 T]

d

4/6 T 是误差矩阵，表达式见前节4.8。
经测试，加工误差的实际参数为：
| △d4 ≈ 1mm
| △α5 ≈ 0.07rad

这样，可以通过实时计算对末端位姿误差进行补偿，在加工精度不高的情况 下仍能保持定位精度。

### 4.4.2 高阶误差

实际上每个连杆之间都有一定的偏差，准确的机械臂模型应该表示为：

0/6 TR =

∏
| 5

i=0

(
i
i+1

T + d

i
i+1

T

)
(4.9)

整理得4.9：

0/6 TR −

0/6 T =

∑∞

i=1

errori | (4.10)

其中，errori 为 i 阶误差，一阶误差为：

error1 =

∑
5

i=0

∏
5

j=0,j̸=i

j
j+1

T · d

i
i+1

T

高阶误差同理。本文不再分析高阶的影响。

### 4.5 本章小结

本章主要介绍了根据改进 D-H 方法来对机械臂误差建模。分析了核心零部 件的影响，通过误差原理计算总的定位误差。这对以后指导机械臂标定、误差矫 正，乃至分配机械零件加工精度都有重要意义。这里需要指出的是，本章分析仅 针对加工装配误差较大的腕关节部位，属于一阶误差的主要部分。如果需得到准 确的误差模型，还要分析二阶误差等以及提高检测标定精度。例如可以通过运动 捕捉系统 [18] 来确定连杆结构的参数和误差。
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
