jony6/-MechanicalDesign/六自由度机械臂/图纸/1.jpg

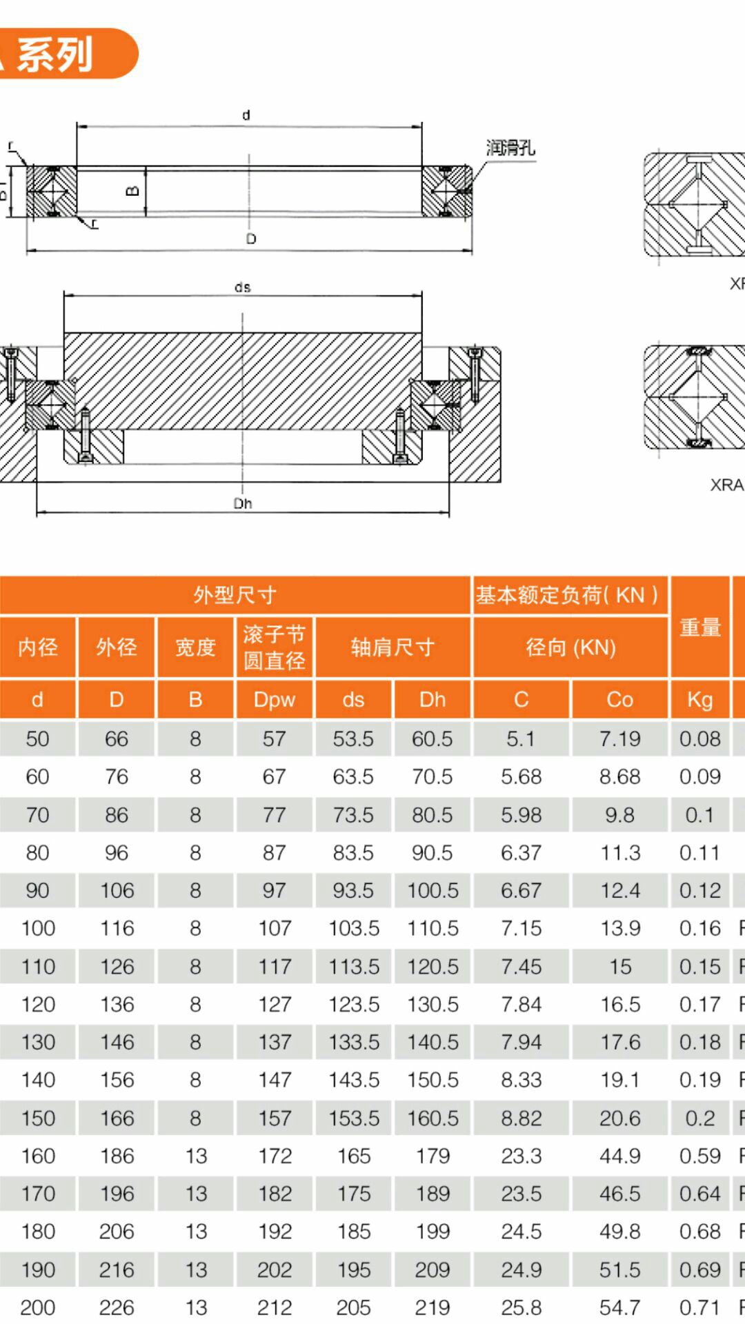
六自由度机械臂/图纸/1.jpg
