jony6/-MechanicalDesign/六自由度机械臂/图纸/RE4510交叉滚子轴承/QQ截图20160312155750.png

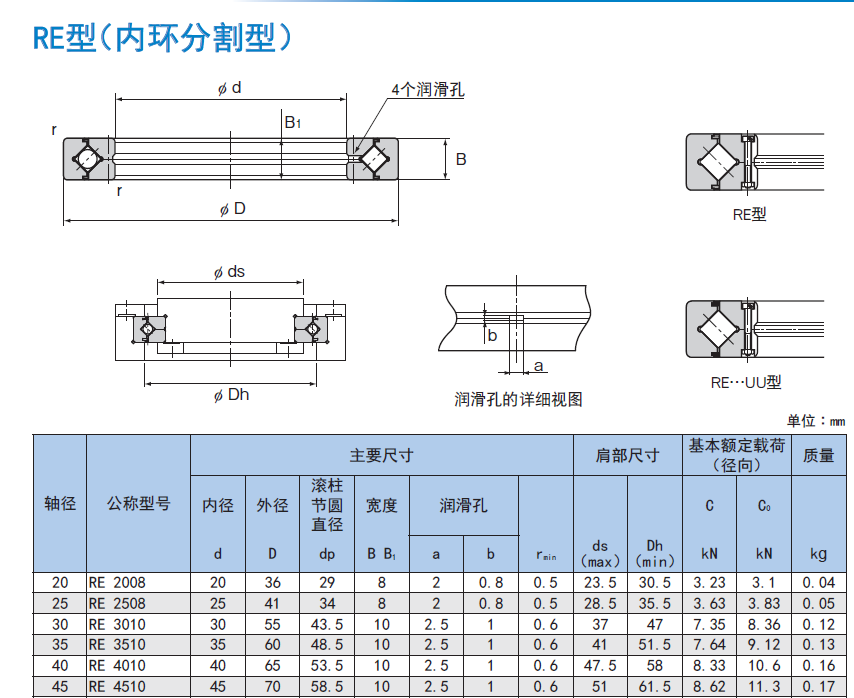
六自由度机械臂/图纸/RE4510交叉滚子轴承/QQ截图20160312155750.png
