jony6/-MechanicalDesign/六自由度机械臂/图纸/圆锥齿轮参数.png

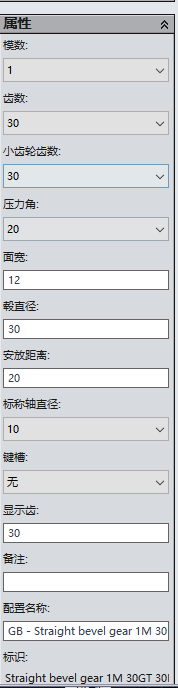
六自由度机械臂/图纸/圆锥齿轮参数.png
