jony6/-MechanicalDesign/软体手爪/img/Model.png

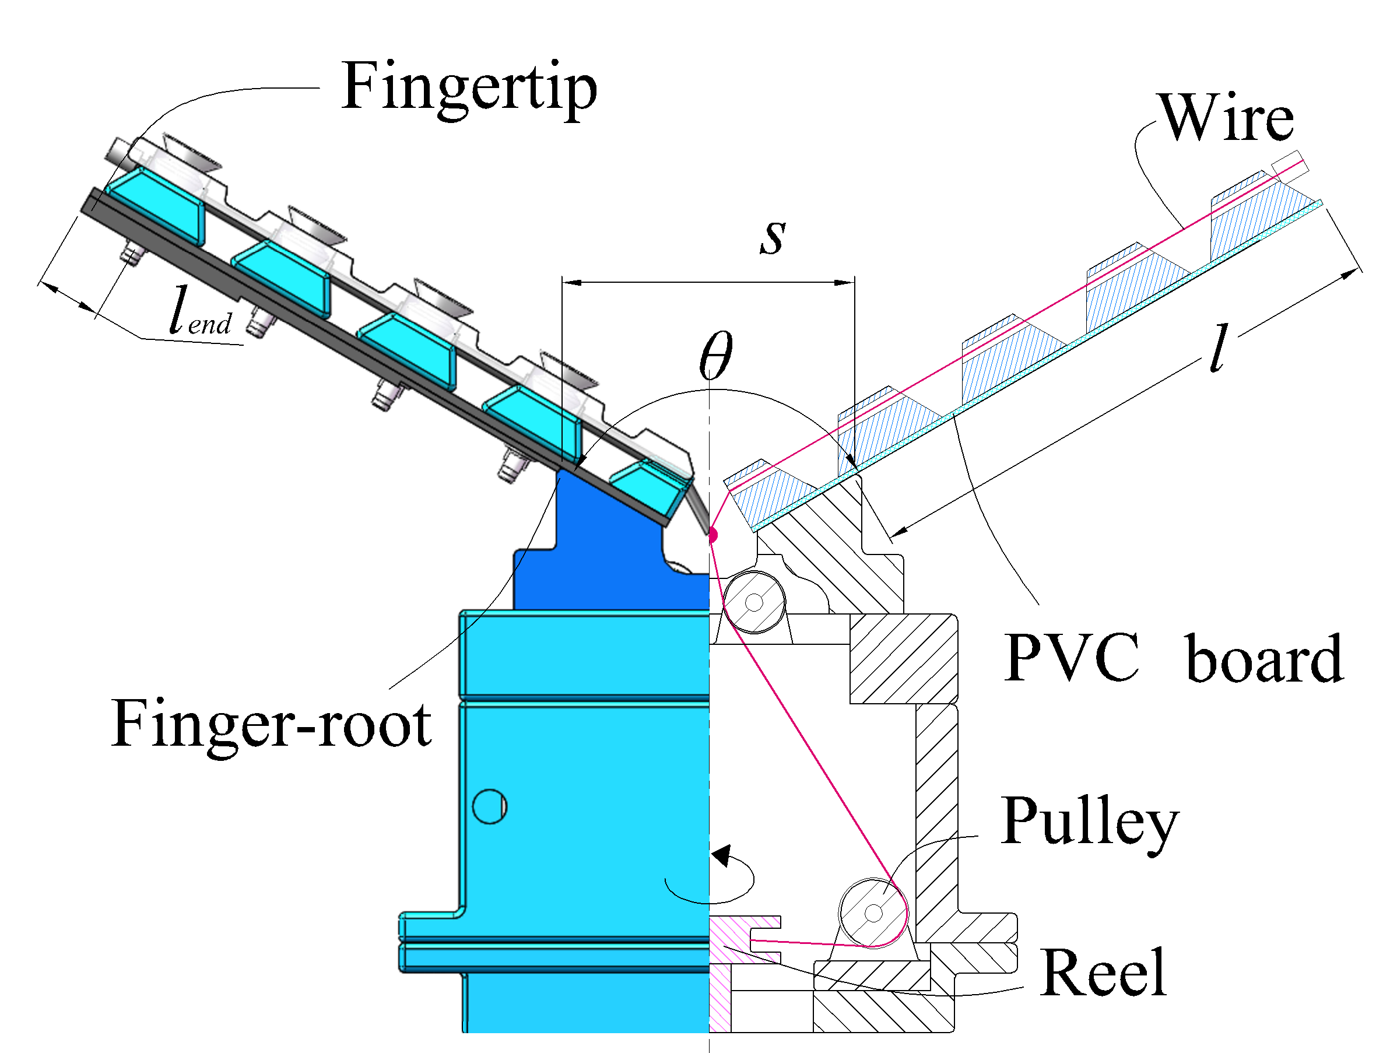
软体手爪/img/Model.png
