jony6/-MechanicalDesign/六自由度机械臂/图纸/shoubi_asm.SLDPRT

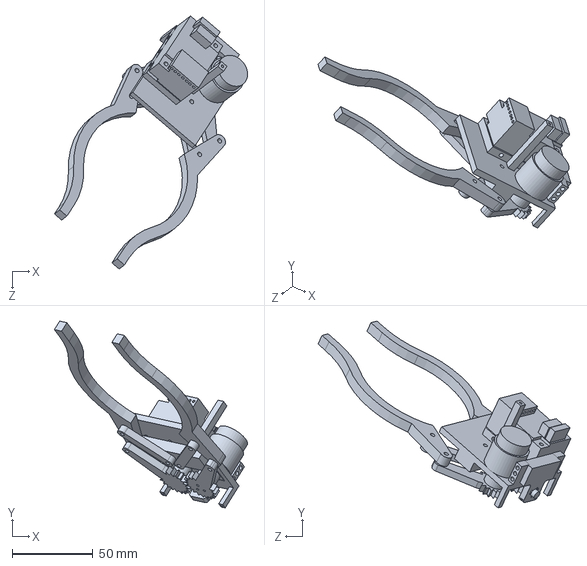
[picture p33: CAD file, 2018-06-09]
六自由度机械臂/图纸/shoubi_asm.SLDPRT
119.3 x 115.3 x 156.2 mm
