jony6/-MechanicalDesign/六自由度机械臂/图纸/装配体 2.SLDASM

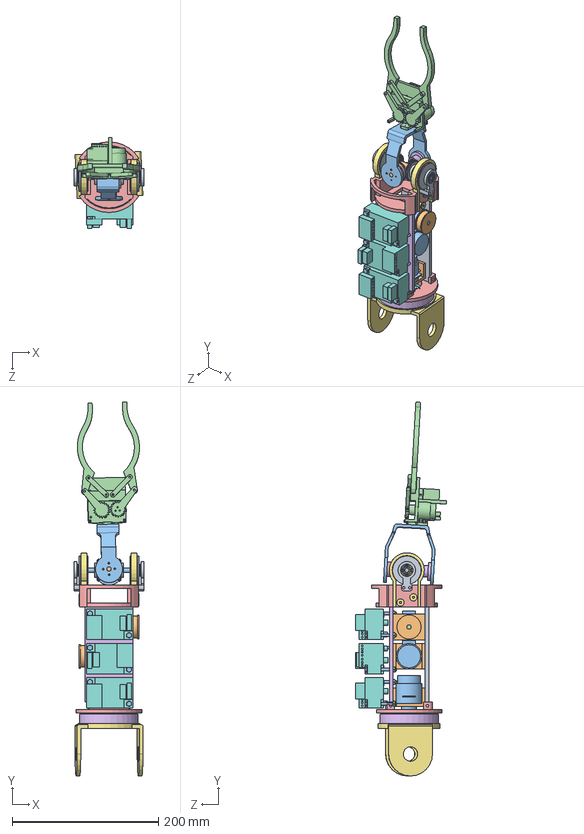
[picture p36: CAD file, 2018-06-09]
六自由度机械臂/图纸/装配体 2.SLDASM
96.0 x 510.8 x 124.1 mm
机械臂主支撑板
电机支架 x 3
电机 x 3
电机与同步带轮连接法兰 x 2
腕部基座
机械臂辅助支撑板
主动锥齿轮固定架
驱动板 x 3
行星轴支撑座 x 2
deep groove ball bearings gb x 5
腕关节连接架
shoubi_asm
从动锥齿轮和腕关节支架法兰连接盘
腕关节支架法兰连接盘2
小涨紧轮 x 4
交叉滚子轴承
大同步轮 x 2
小同步轮 x 2
hexagon head bolts-full thread gb x 6
hex nuts, style 1-grades ab gb x 6
肘关节连接件
肘关节上连接件
上臂
电机连接盘
straight bevel gear_gb x 3
新行星齿轮轴
齿轮轴 x 2
