jony6/-MechanicalDesign/六自由度机械臂/图纸/电路驱动板.SLDASM

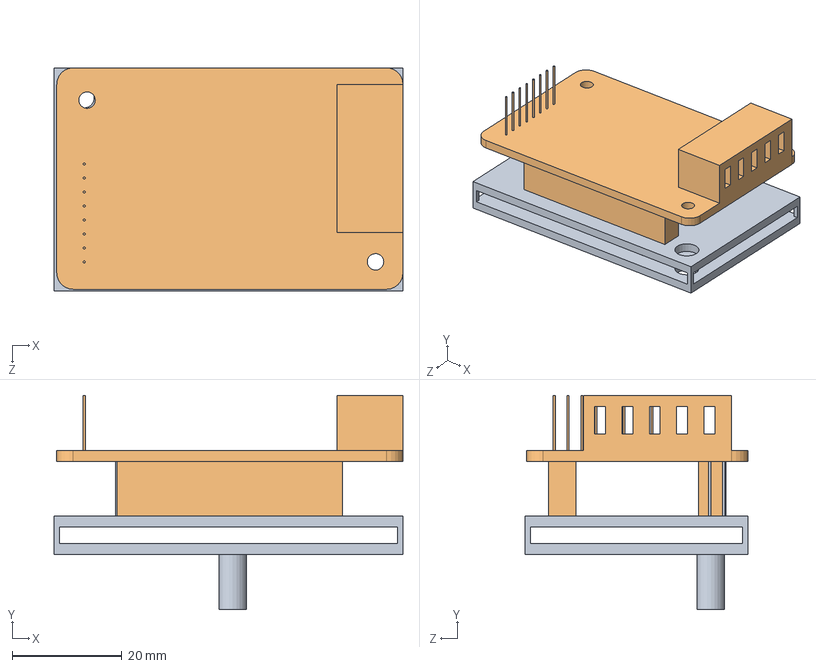
[picture p37: CAD file, 2018-06-09]
六自由度机械臂/图纸/电路驱动板.SLDASM
63.5 x 39.0 x 40.6 mm
电机驱动板_ACK_055_06
电机驱动转接板
