jony6/-MechanicalDesign/六自由度机械臂/图纸/RE4510交叉滚子轴承/交叉滚子轴承.SLDPRT

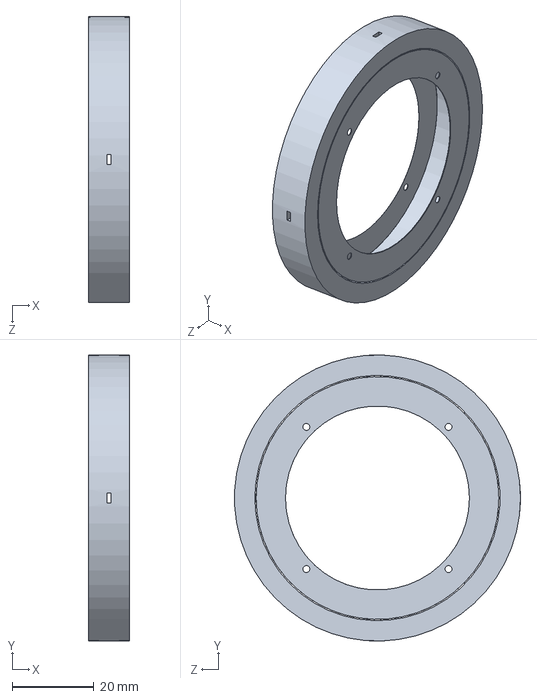
[picture p38: CAD file, 2018-06-09]
六自由度机械臂/图纸/RE4510交叉滚子轴承/交叉滚子轴承.SLDPRT
10.0 x 70.0 x 70.0 mm
