jony6/-MechanicalDesign/六自由度机械臂/图纸/大同步轮.SLDPRT

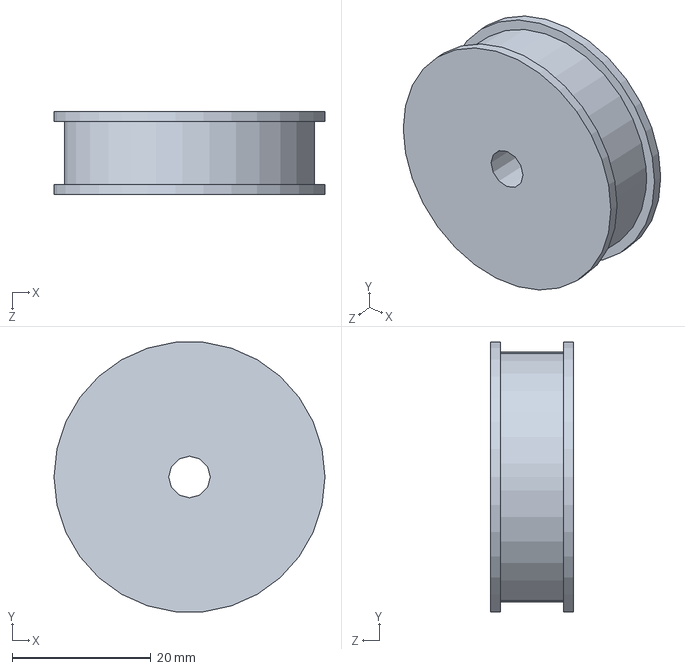
[picture p39: CAD file, 2018-06-09]
六自由度机械臂/图纸/大同步轮.SLDPRT
39.0 x 38.8 x 12.0 mm
