jony6/-MechanicalDesign/六自由度机械臂/图纸/新十字轴/straight bevel gear_gb.sldprt

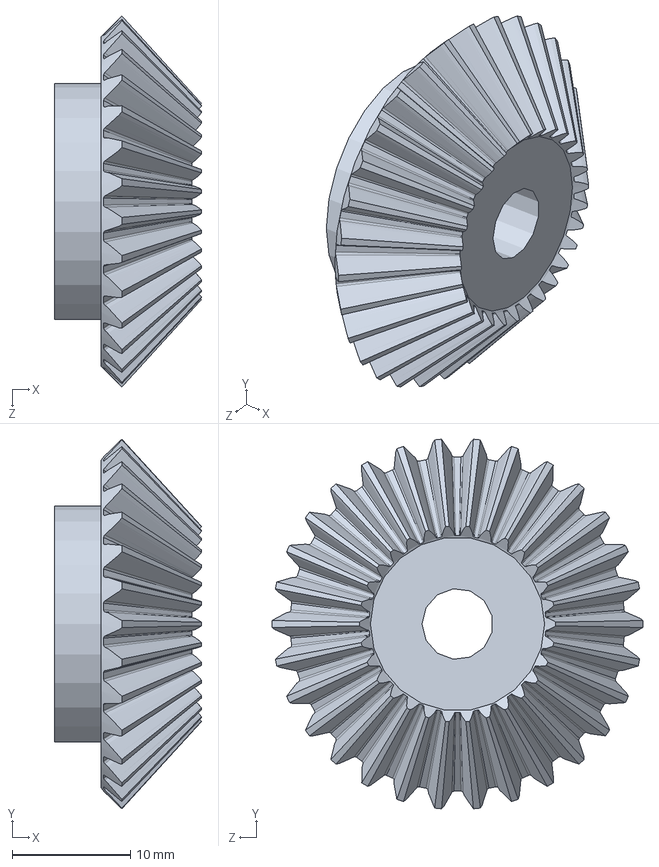
[picture p40: CAD file, 2018-06-09]
六自由度机械臂/图纸/新十字轴/straight bevel gear_gb.sldprt
12.4 x 31.3 x 31.4 mm
