jony6/-MechanicalDesign/六自由度机械臂/图纸/从动锥齿轮和腕关节支架法兰连接盘.SLDPRT

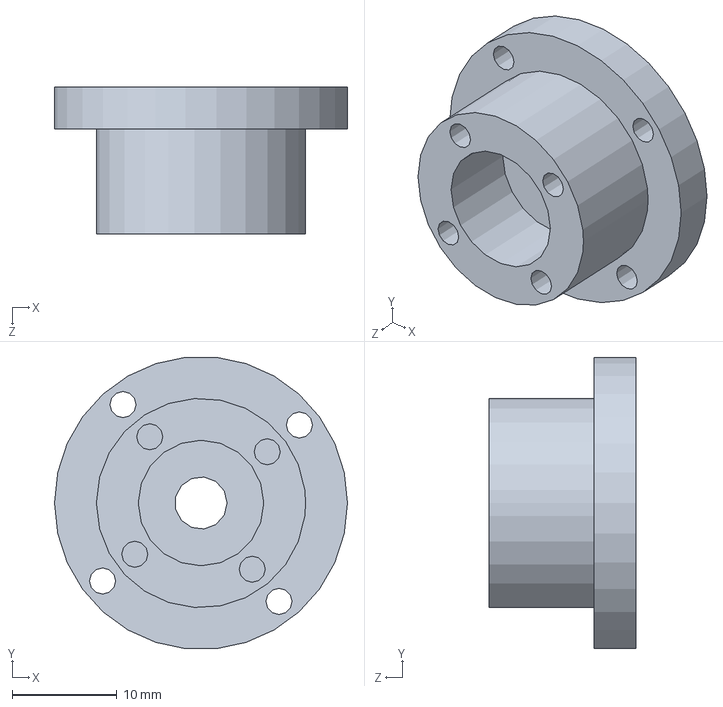
[picture p41: CAD file, 2018-06-09]
六自由度机械臂/图纸/从动锥齿轮和腕关节支架法兰连接盘.SLDPRT
28.0 x 27.8 x 14.0 mm
