jony6/-MechanicalDesign/六自由度机械臂/图纸/新十字轴/新行星齿轮轴.SLDPRT

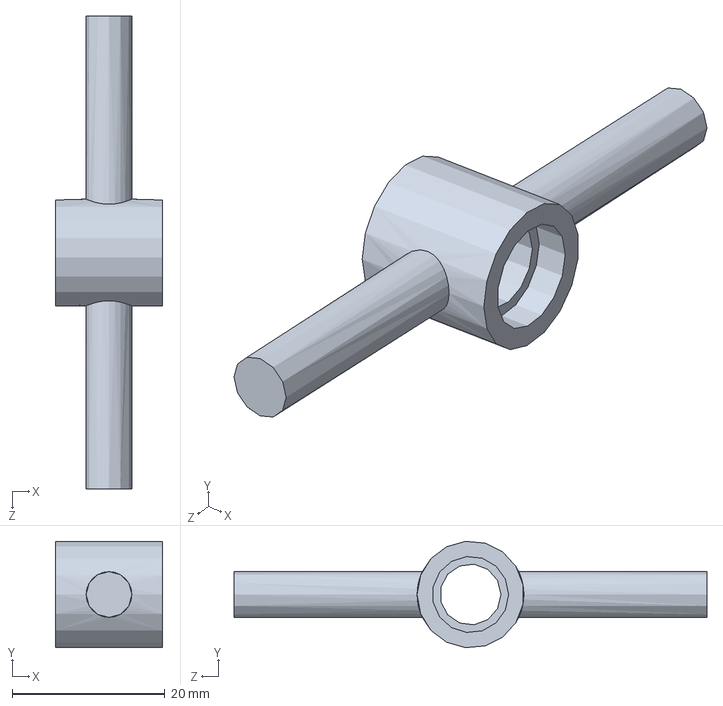
[picture p42: CAD file, 2018-06-09]
六自由度机械臂/图纸/新十字轴/新行星齿轮轴.SLDPRT
14.0 x 13.9 x 62.0 mm
