jony6/-MechanicalDesign/六自由度机械臂/图纸/新十字轴/齿轮轴.SLDPRT

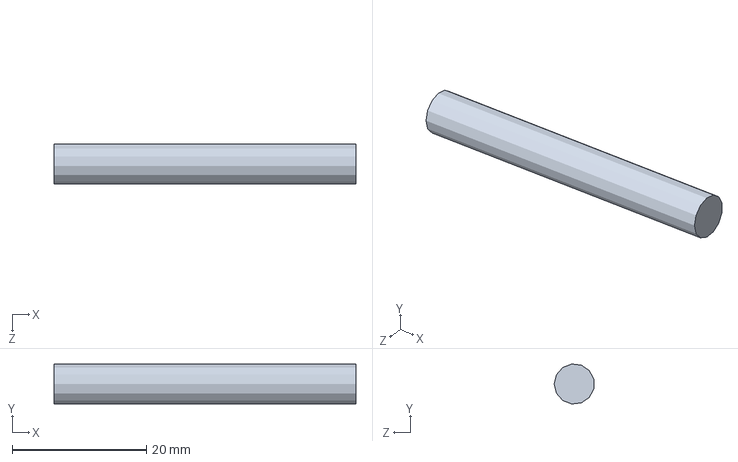
[picture p43: CAD file, 2018-06-09]
六自由度机械臂/图纸/新十字轴/齿轮轴.SLDPRT
45.0 x 5.96 x 5.91 mm
