jony6/-MechanicalDesign/六自由度机械臂/图纸/新圆锥齿轮.sldprt

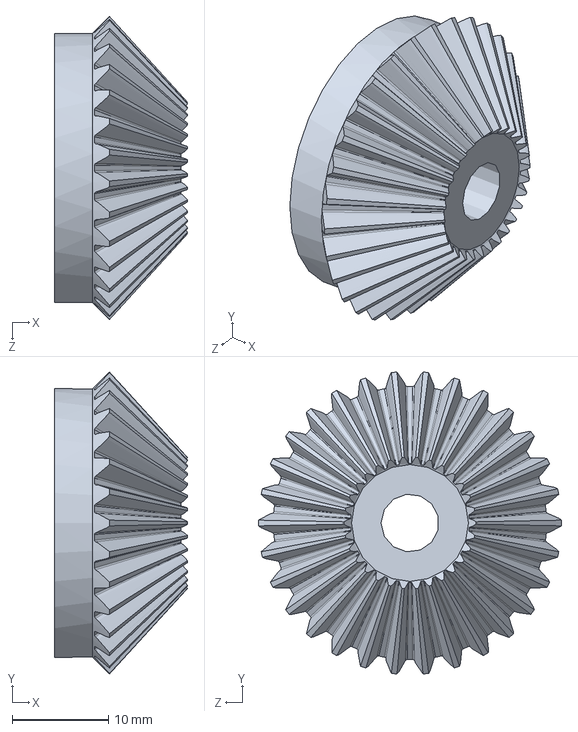
[picture p44: CAD file, 2018-06-09]
六自由度机械臂/图纸/新圆锥齿轮.sldprt
13.8 x 31.3 x 31.4 mm
