jony6/-MechanicalDesign/六自由度机械臂/图纸/锥齿轮.SLDPRT

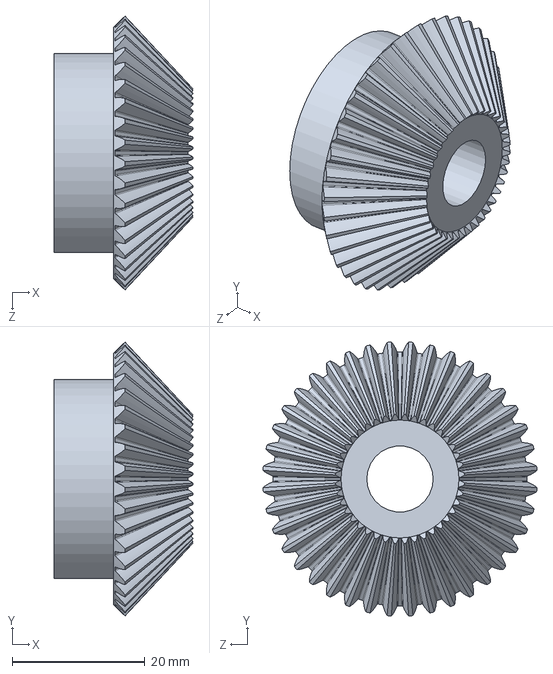
[picture p45: CAD file, 2018-06-09]
六自由度机械臂/图纸/锥齿轮.SLDPRT
20.9 x 41.3 x 41.3 mm
