jony6/-MechanicalDesign/六自由度机械臂/图纸/腕关节支架法兰连接盘2.SLDPRT

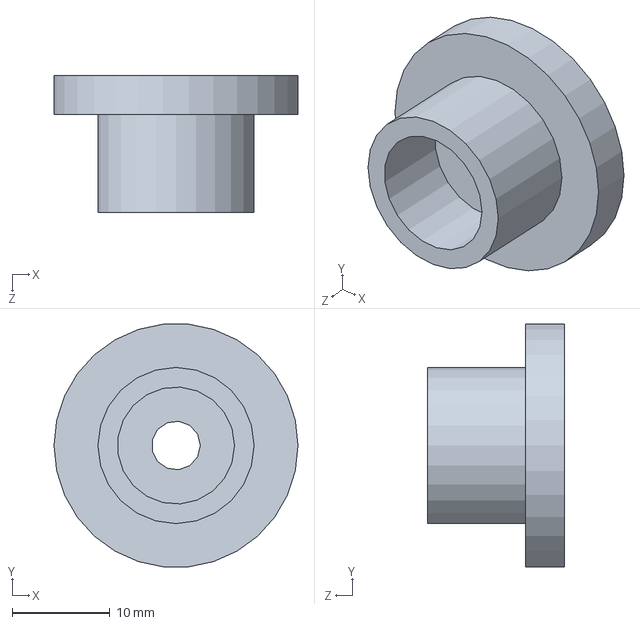
[picture p46: CAD file, 2018-06-09]
六自由度机械臂/图纸/腕关节支架法兰连接盘2.SLDPRT
25.0 x 24.9 x 14.0 mm
