jony6/-MechanicalDesign/六自由度机械臂/图纸/行星轴支撑座.SLDPRT

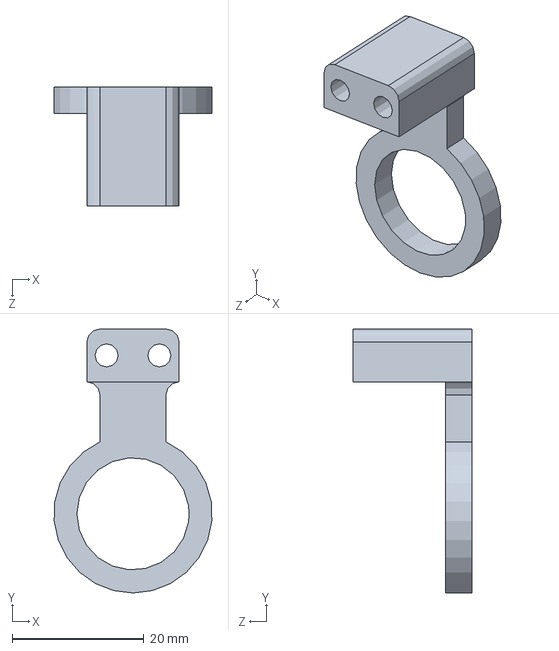
[picture p47: CAD file, 2018-06-09]
六自由度机械臂/图纸/行星轴支撑座.SLDPRT
23.9 x 40.0 x 18.0 mm
