jony6/-MechanicalDesign/六自由度机械臂/图纸/同步带轮和锥齿轮连接盘.SLDPRT

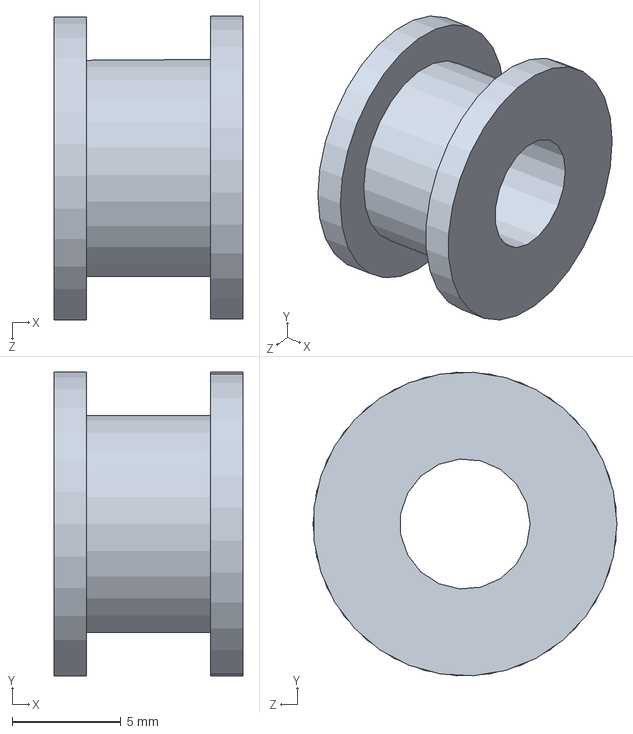
[picture p48: CAD file, 2018-06-09]
六自由度机械臂/图纸/同步带轮和锥齿轮连接盘.SLDPRT
8.70 x 14.0 x 14.0 mm
