jony6/-MechanicalDesign/六自由度机械臂/图纸/行星齿轮轴.SLDPRT

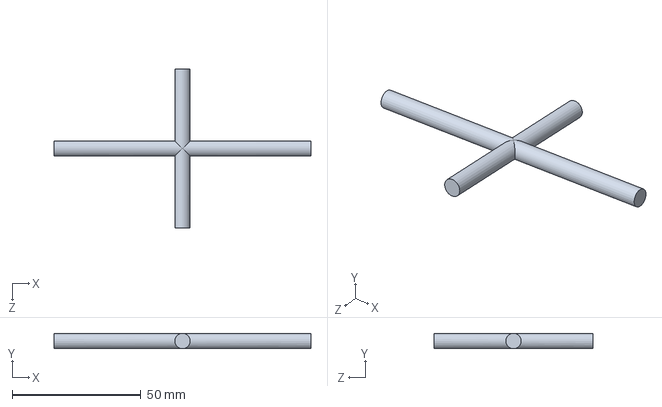
[picture p49: CAD file, 2018-06-09]
六自由度机械臂/图纸/行星齿轮轴.SLDPRT
100.0 x 6.00 x 62.0 mm
