jony6/-MechanicalDesign/六自由度机械臂/图纸/同步带.SLDPRT

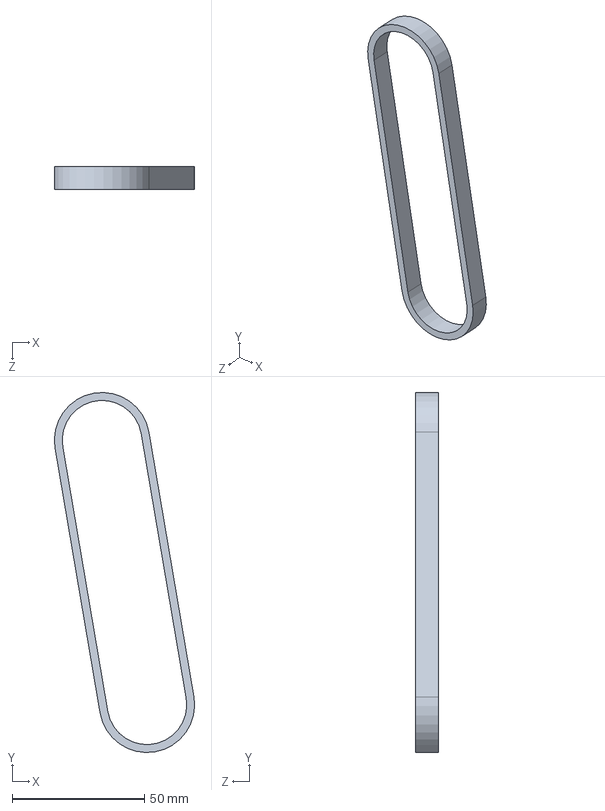
[picture p50: CAD file, 2018-06-09]
六自由度机械臂/图纸/同步带.SLDPRT
53.0 x 136.0 x 8.50 mm
