jony6/-MechanicalDesign/六自由度机械臂/图纸/电机驱动板_ACK_055_06.SLDPRT

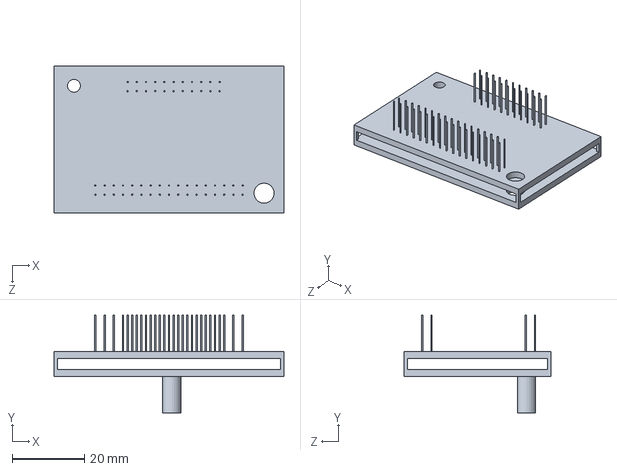
[picture p51: CAD file, 2018-06-09]
六自由度机械臂/图纸/电机驱动板_ACK_055_06.SLDPRT
63.5 x 27.0 x 40.6 mm
