jony6/-MechanicalDesign/六自由度机械臂/图纸/肘关节连接法兰.SLDPRT

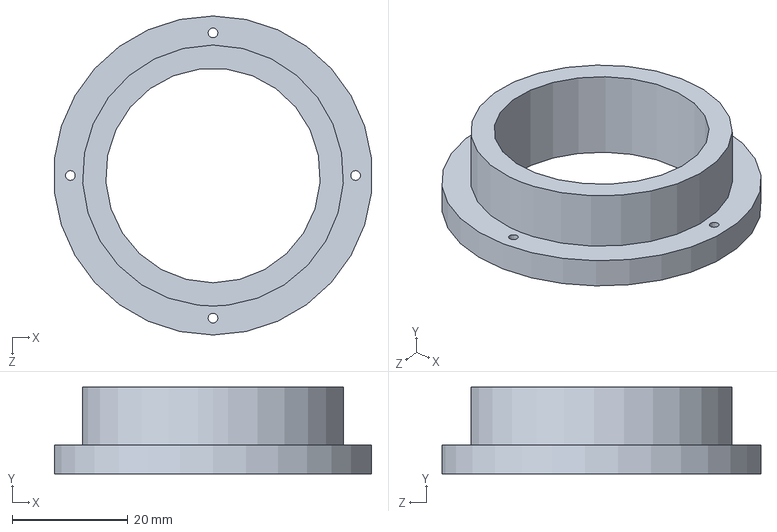
[picture p52: CAD file, 2018-06-09]
六自由度机械臂/图纸/肘关节连接法兰.SLDPRT
54.7 x 15.0 x 55.0 mm
