jony6/-MechanicalDesign/六自由度机械臂/图纸/上臂.SLDPRT

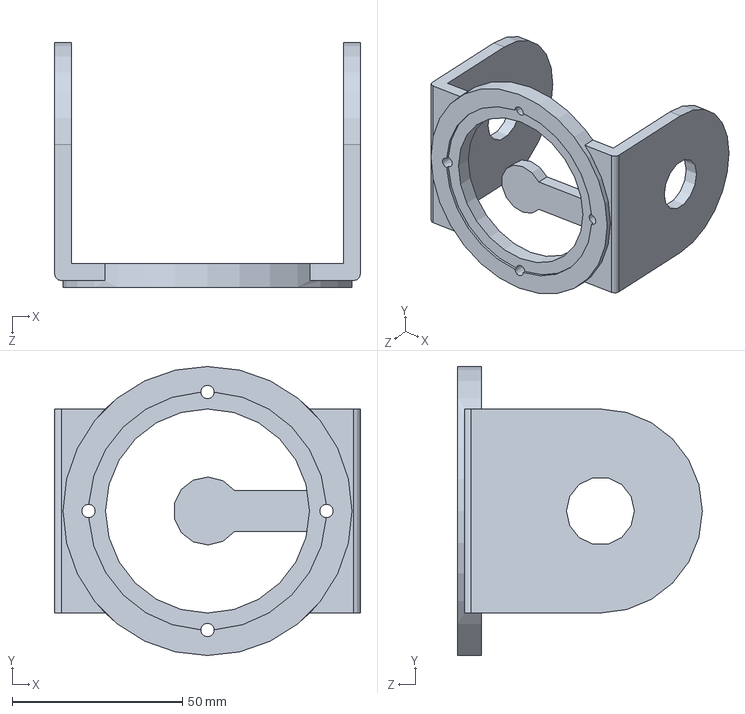
[picture p53: CAD file, 2018-06-09]
六自由度机械臂/图纸/上臂.SLDPRT
90.0 x 85.0 x 72.0 mm
