jony6/-MechanicalDesign/六自由度机械臂/图纸/电机驱动转接板.SLDPRT

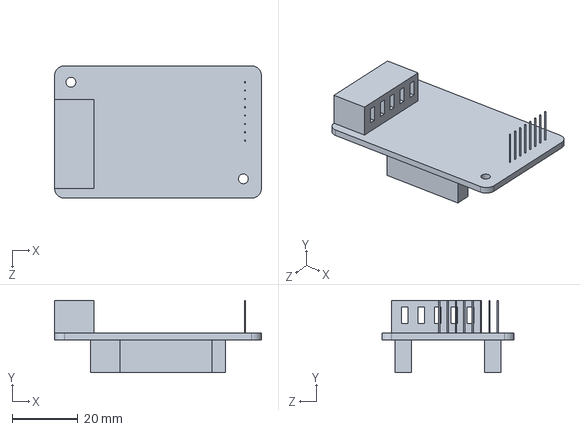
[picture p54: CAD file, 2018-06-09]
六自由度机械臂/图纸/电机驱动转接板.SLDPRT
63.0 x 22.0 x 40.3 mm
