jony6/-MechanicalDesign/六自由度机械臂/图纸/主动锥齿轮固定架.SLDPRT

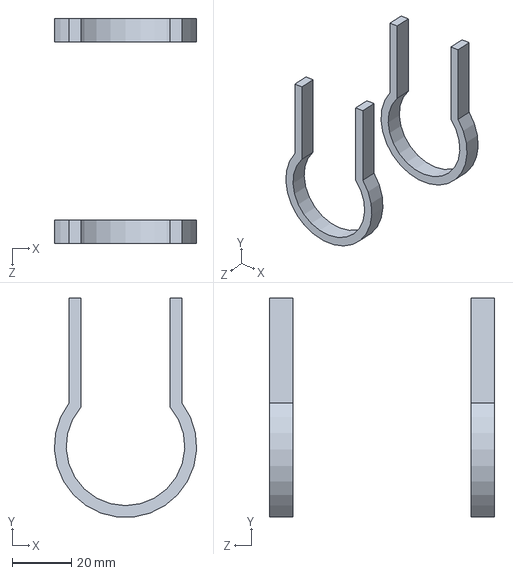
[picture p55: CAD file, 2018-06-09]
六自由度机械臂/图纸/主动锥齿轮固定架.SLDPRT
47.9 x 73.8 x 76.0 mm
