jony6/-MechanicalDesign/六自由度机械臂/图纸/新十字轴.SLDPRT

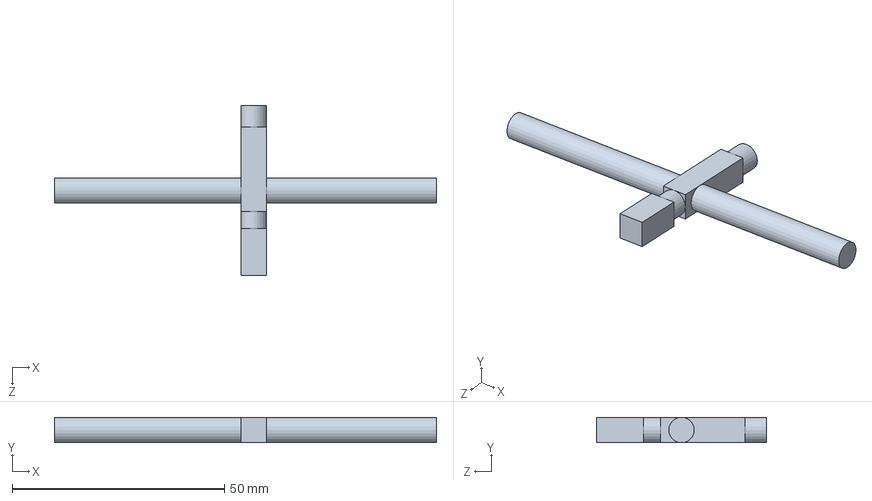
[picture p56: CAD file, 2018-06-09]
六自由度机械臂/图纸/新十字轴.SLDPRT
90.0 x 6.00 x 40.0 mm
