jony6/-MechanicalDesign/六自由度机械臂/图纸/机械臂主支撑板.SLDPRT

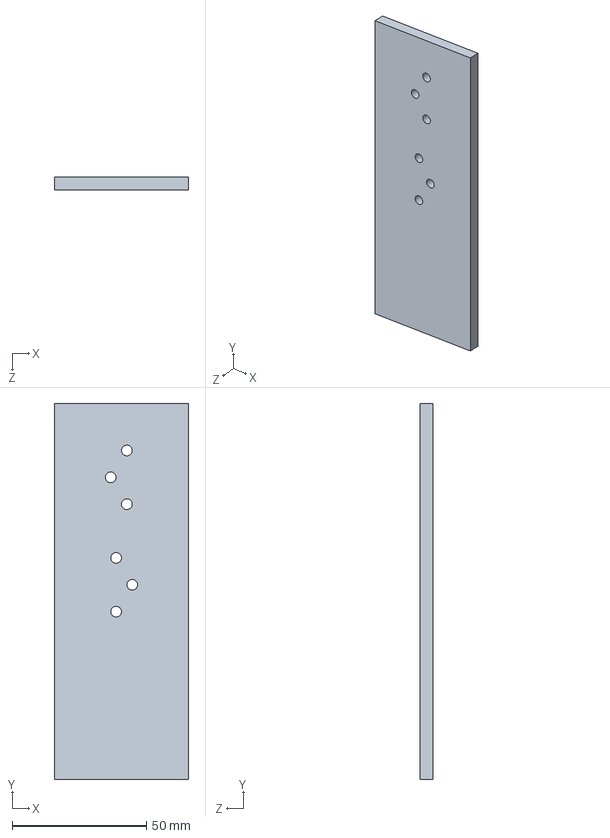
[picture p57: CAD file, 2018-06-09]
六自由度机械臂/图纸/机械臂主支撑板.SLDPRT
50.0 x 140.0 x 5.00 mm
