jony6/-MechanicalDesign/六自由度机械臂/图纸/电机.SLDPRT

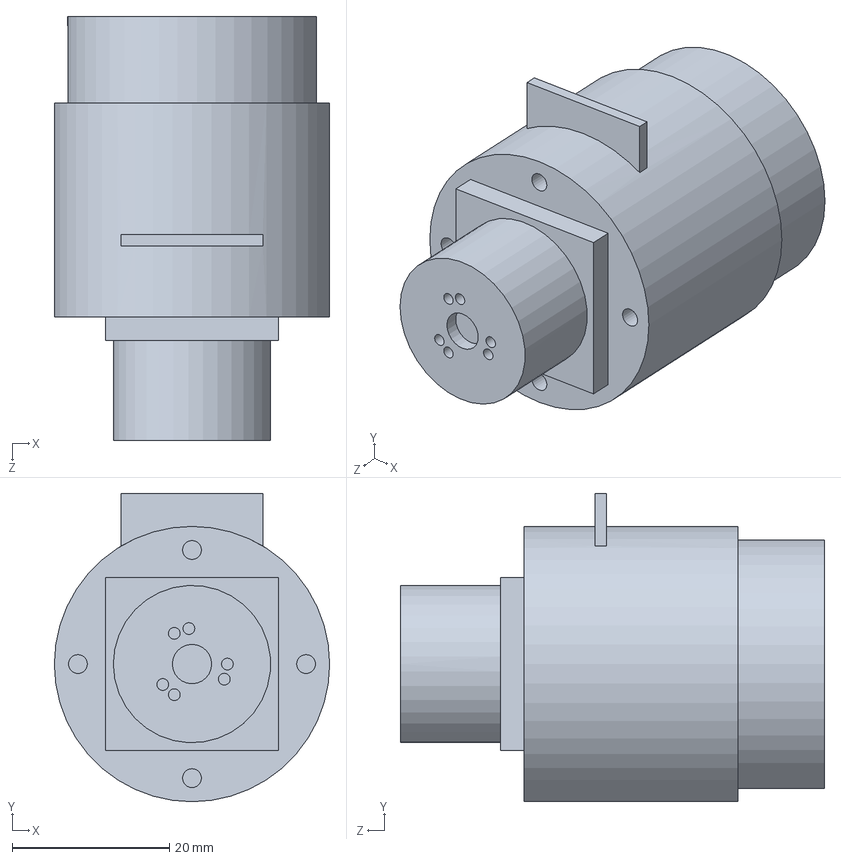
[picture p58: CAD file, 2018-06-09]
六自由度机械臂/图纸/电机.SLDPRT
35.0 x 39.2 x 53.9 mm
