jony6/-MechanicalDesign/六自由度机械臂/图纸/肘关节连接件.SLDPRT

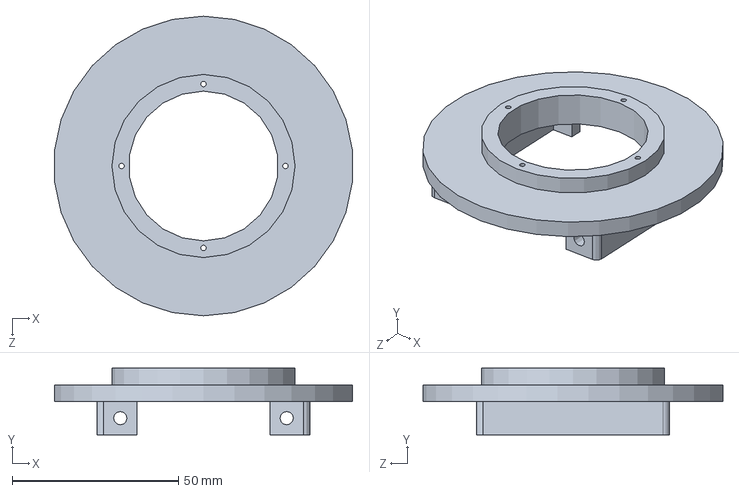
[picture p59: CAD file, 2018-06-09]
六自由度机械臂/图纸/肘关节连接件.SLDPRT
89.5 x 20.0 x 90.0 mm
