jony6/-MechanicalDesign/六自由度机械臂/图纸/电机连接盘.SLDPRT

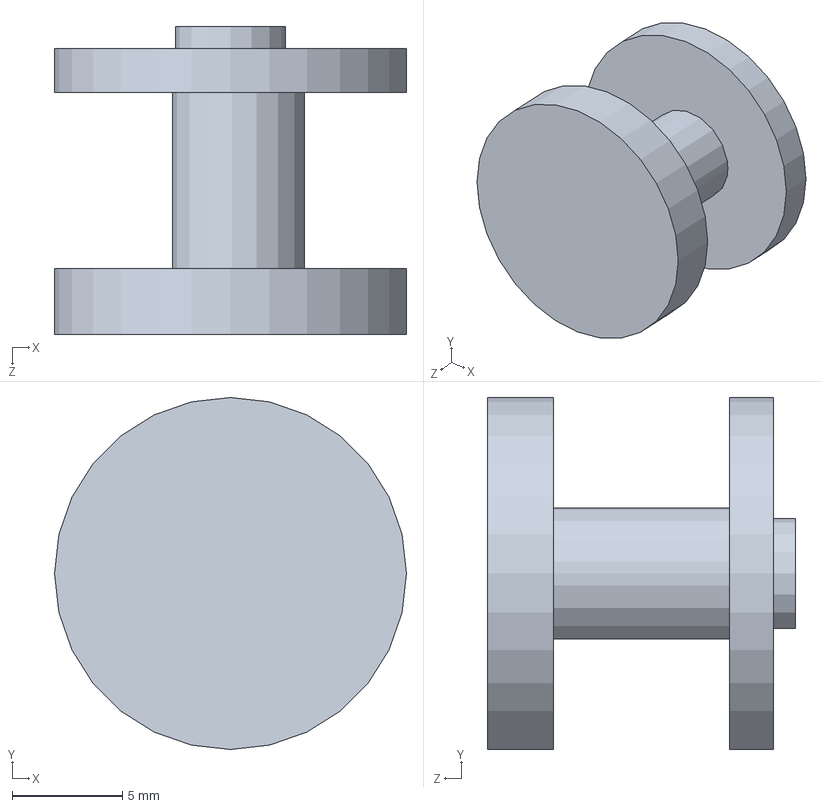
[picture p60: CAD file, 2018-06-09]
六自由度机械臂/图纸/电机连接盘.SLDPRT
16.0 x 16.0 x 14.0 mm
