jony6/-MechanicalDesign/六自由度机械臂/图纸/同步带new1.SLDPRT

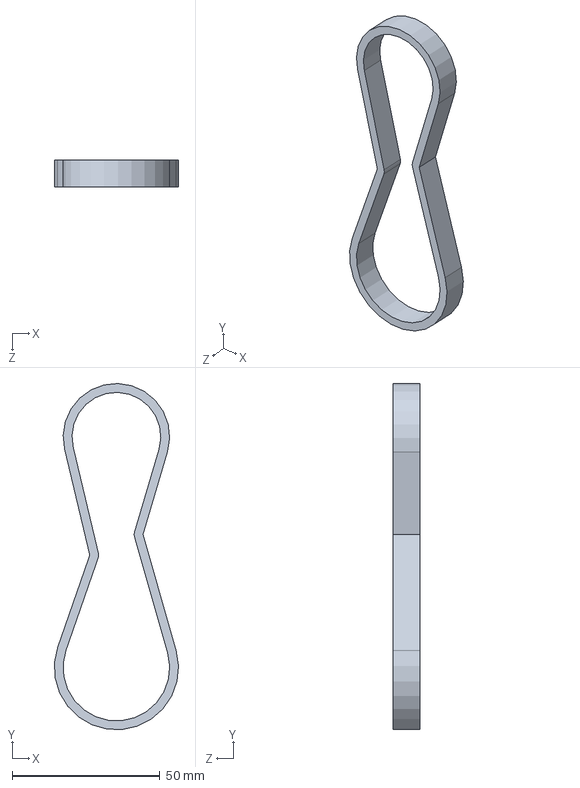
[picture p61: CAD file, 2018-06-09]
六自由度机械臂/图纸/同步带new1.SLDPRT
41.9 x 116.9 x 9.00 mm
