jony6/-MechanicalDesign/六自由度机械臂/图纸/肘关节上连接件.SLDPRT

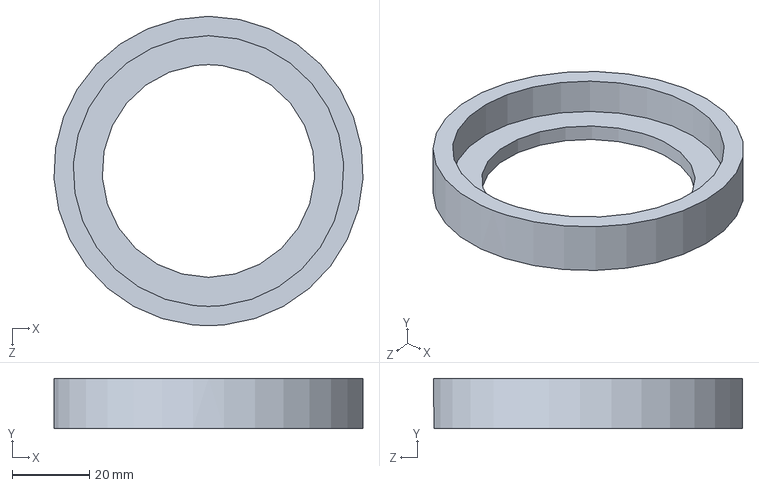
[picture p62: CAD file, 2018-06-09]
六自由度机械臂/图纸/肘关节上连接件.SLDPRT
79.9 x 13.0 x 80.0 mm
