jony6/-MechanicalDesign/六自由度机械臂/图纸/腕部基座.SLDPRT

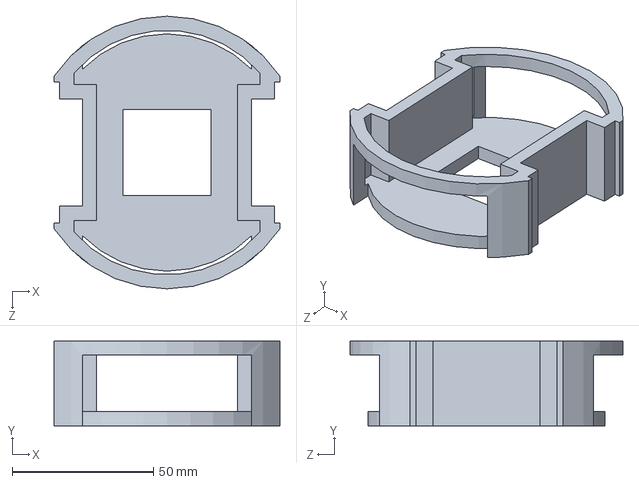
[picture p63: CAD file, 2018-06-09]
六自由度机械臂/图纸/腕部基座.SLDPRT
80.0 x 30.0 x 96.5 mm
