jony6/-MechanicalDesign/六自由度机械臂/图纸/同步带new2.SLDPRT

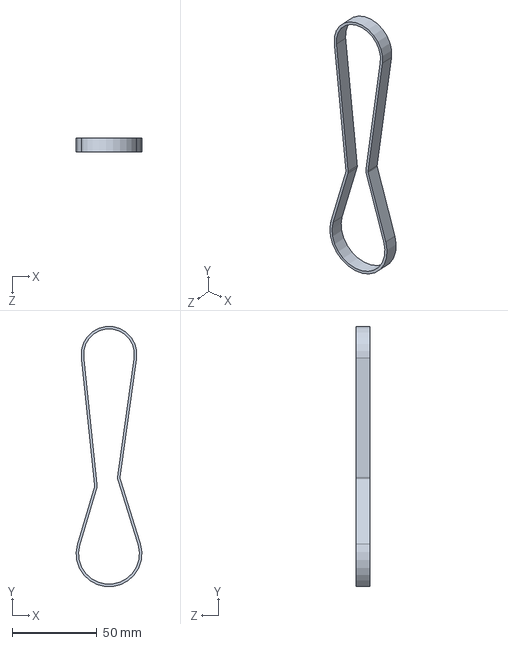
[picture p64: CAD file, 2018-06-09]
六自由度机械臂/图纸/同步带new2.SLDPRT
39.0 x 153.8 x 8.00 mm
