jony6/-MechanicalDesign/六自由度机械臂/图纸/电机与同步带轮连接法兰.SLDPRT

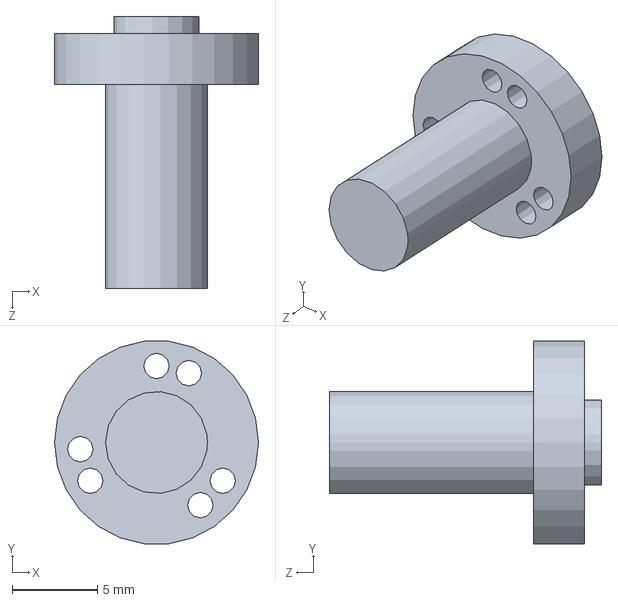
[picture p65: CAD file, 2018-06-09]
六自由度机械臂/图纸/电机与同步带轮连接法兰.SLDPRT
12.0 x 11.9 x 16.0 mm
