jony6/-MechanicalDesign/六自由度机械臂/图纸/小涨紧轮.SLDPRT

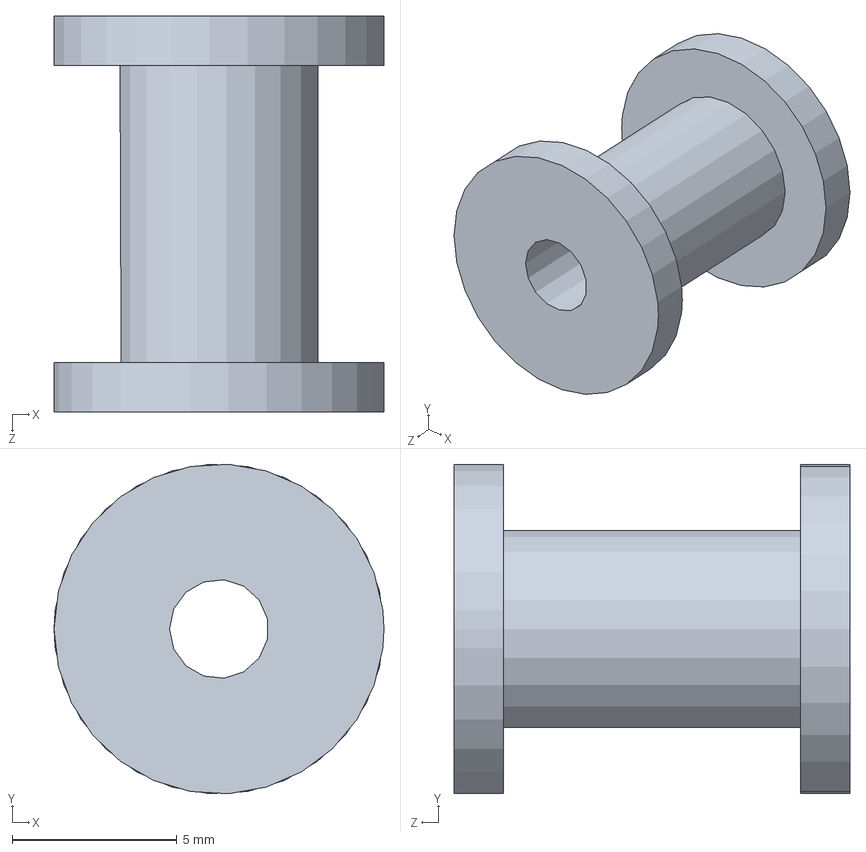
[picture p66: CAD file, 2018-06-09]
六自由度机械臂/图纸/小涨紧轮.SLDPRT
10.0 x 9.98 x 12.0 mm
