jony6/-MechanicalDesign/六自由度机械臂/图纸/行星连杆.SLDPRT

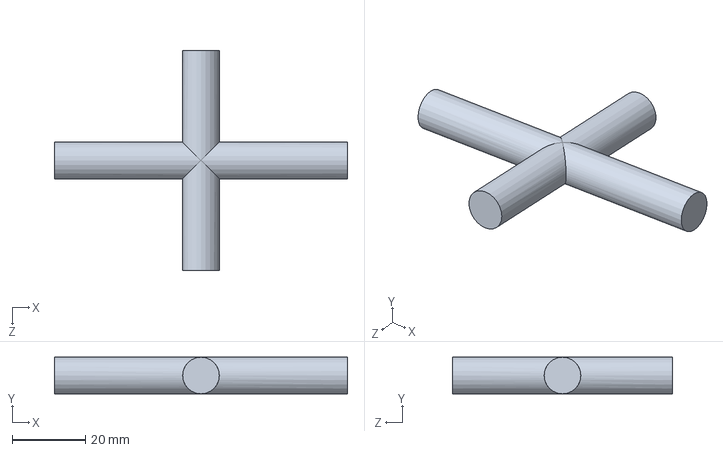
[picture p67: CAD file, 2018-06-09]
六自由度机械臂/图纸/行星连杆.SLDPRT
80.0 x 10.0 x 60.0 mm
