jony6/-MechanicalDesign/六自由度机械臂/图纸/腕关节连接架.SLDPRT

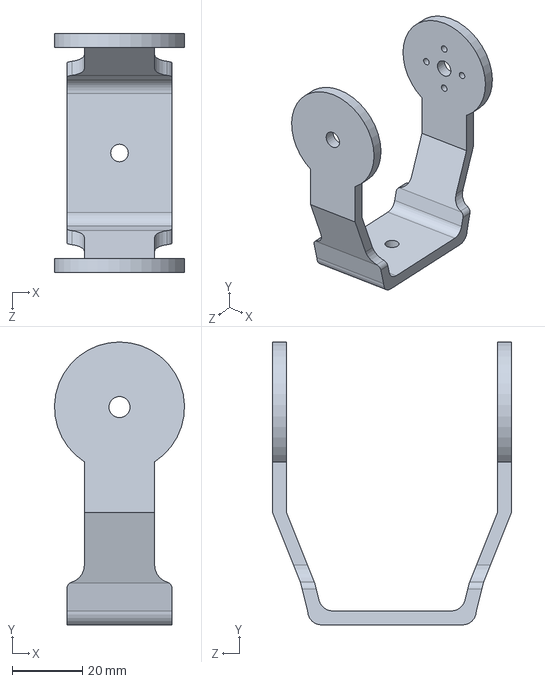
[picture p68: CAD file, 2018-06-09]
六自由度机械臂/图纸/腕关节连接架.SLDPRT
37.0 x 80.5 x 68.0 mm
