jony6/-MechanicalDesign/六自由度机械臂/图纸/小同步轮.SLDPRT

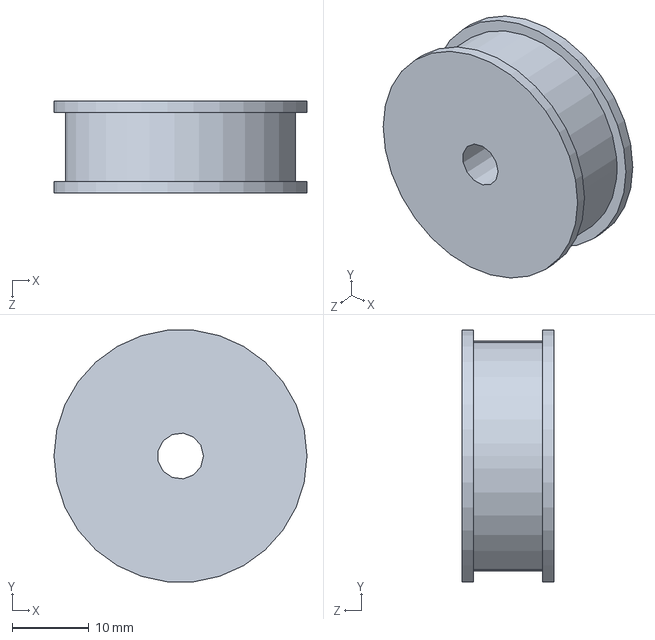
[picture p70: CAD file, 2018-06-09]
六自由度机械臂/图纸/小同步轮.SLDPRT
33.0 x 32.8 x 12.0 mm
