jony6/-MechanicalDesign/六自由度机械臂/图纸/电机支架.SLDPRT

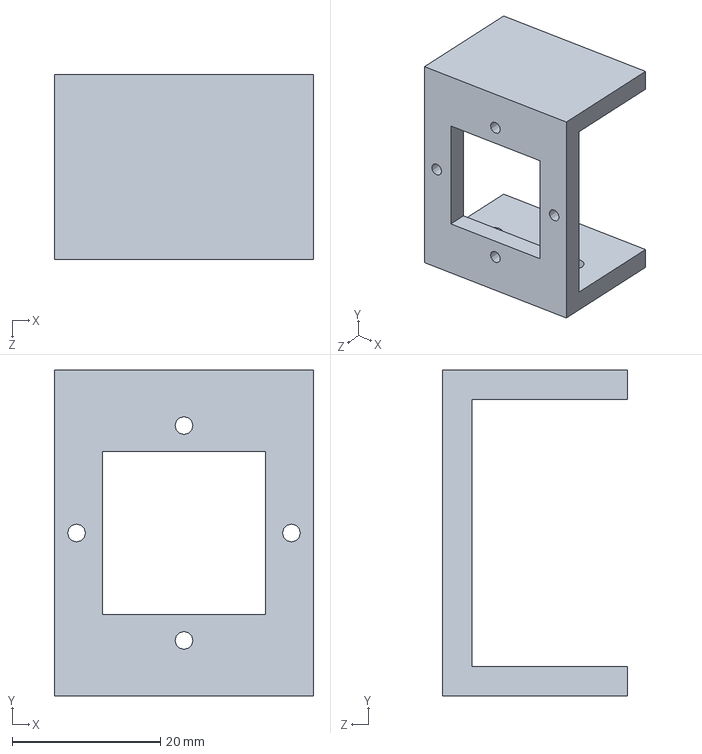
[picture p71: CAD file, 2018-06-09]
六自由度机械臂/图纸/电机支架.SLDPRT
35.0 x 44.0 x 25.0 mm
