jony6/-MechanicalDesign/六自由度机械臂/图纸/驱动板.SLDPRT

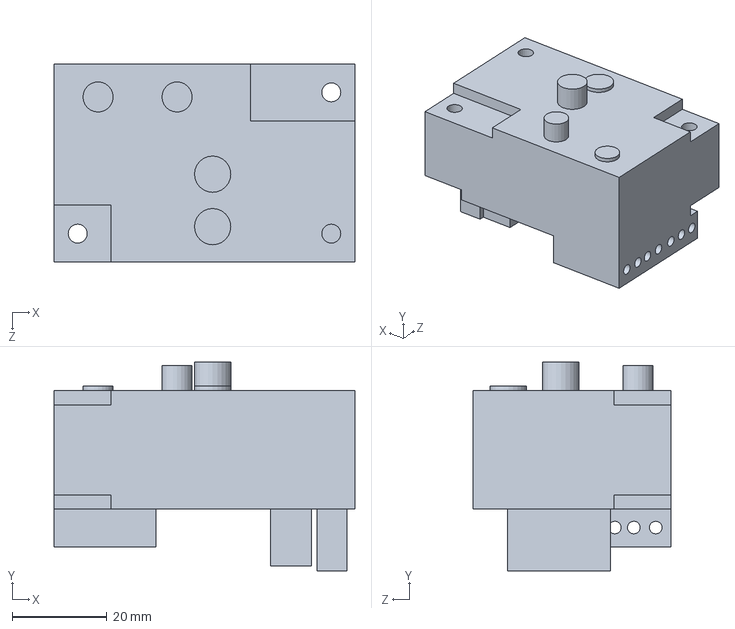
[picture p72: CAD file, 2018-06-09]
六自由度机械臂/图纸/驱动板.SLDPRT
63.5 x 44.0 x 41.8 mm
