jony6/-MechanicalDesign/(commit log)

2018-06-09 add design files
    [shoubi_asm.SLDPRT, straight bevel gear_gb.sldprt, 上臂.SLDPRT, 主动锥齿轮固定架.SLDPRT, 交叉滚子轴承.SLDPRT, 从动锥齿轮和腕关节支架法兰连接盘.SLDPRT, 六自由度机械臂总装图.SLDASM, 同步带.SLDPRT]
2018-06-09 add schematic photo
2018-06-09 add soft arm video
2018-06-10 edit soft gripper readme
2018-06-10 edit soft gripper gif
2018-06-10 edit gripper gif
2018-06-10 gripper gif
2018-06-10 玻璃杯.gif
2018-06-10 6 dof arm
